MagicPrince666/smart_car_chassis/docs/安装ROS2.md

# 安装ros2

## 安装软件包
```
sudo apt install -y build-essential libbullet-dev python3-colcon-common-extensions python3-flake8 python3-pip python3-pytest-cov python3-rosdep2 python3-setuptools python3-vcstool wget
```
