MagicPrince666/smart_car_chassis/docs/驱动板原理图.jpg

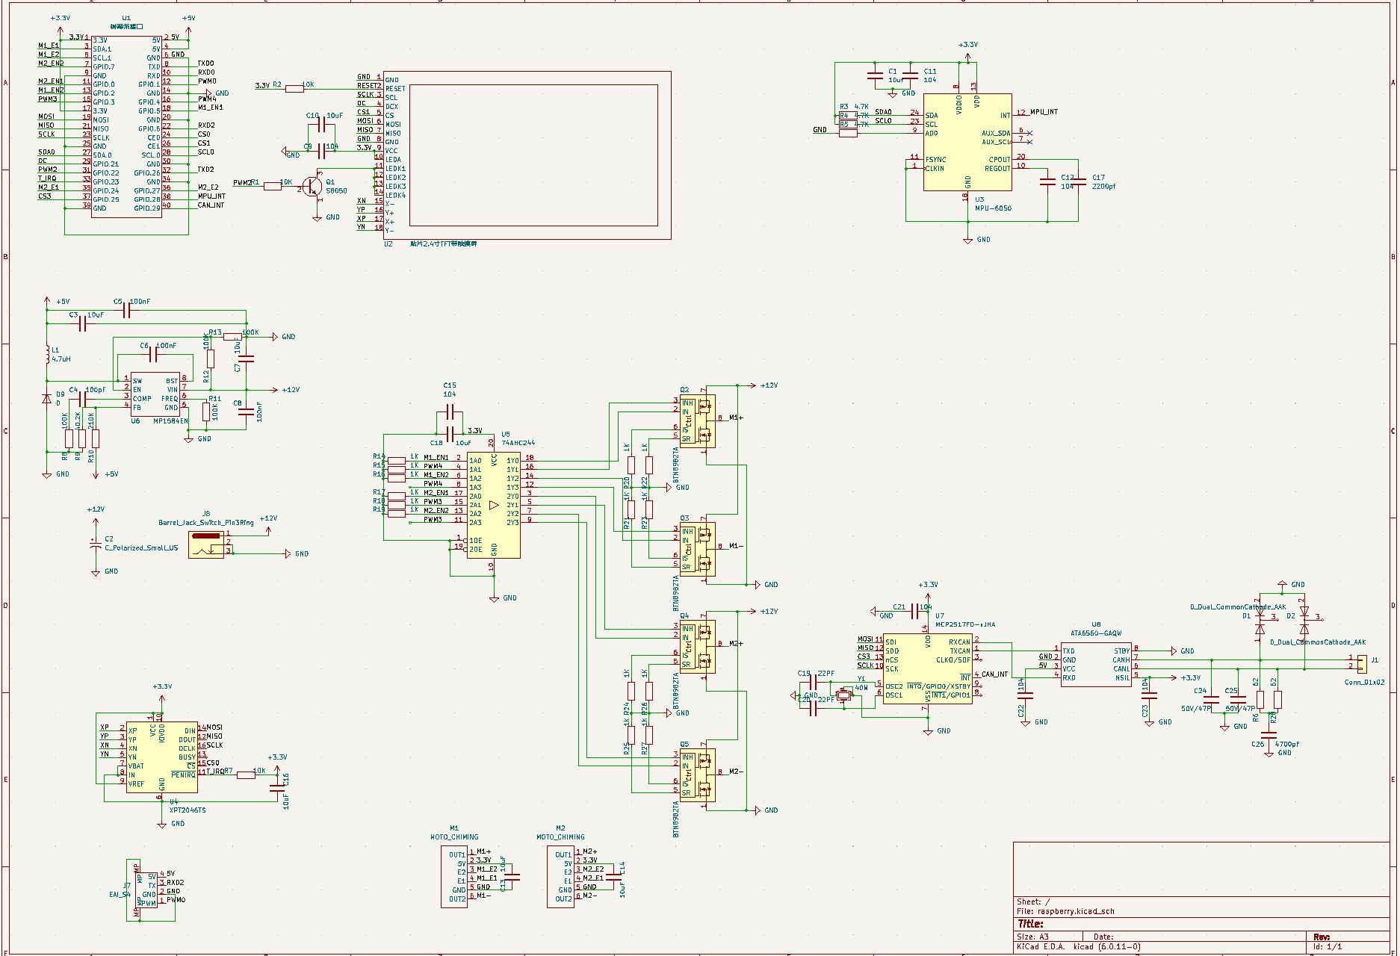
docs/驱动板原理图.jpg
