MagicPrince666/smart_car_chassis/docs/鲁班猫0驱动板原理图.pdf

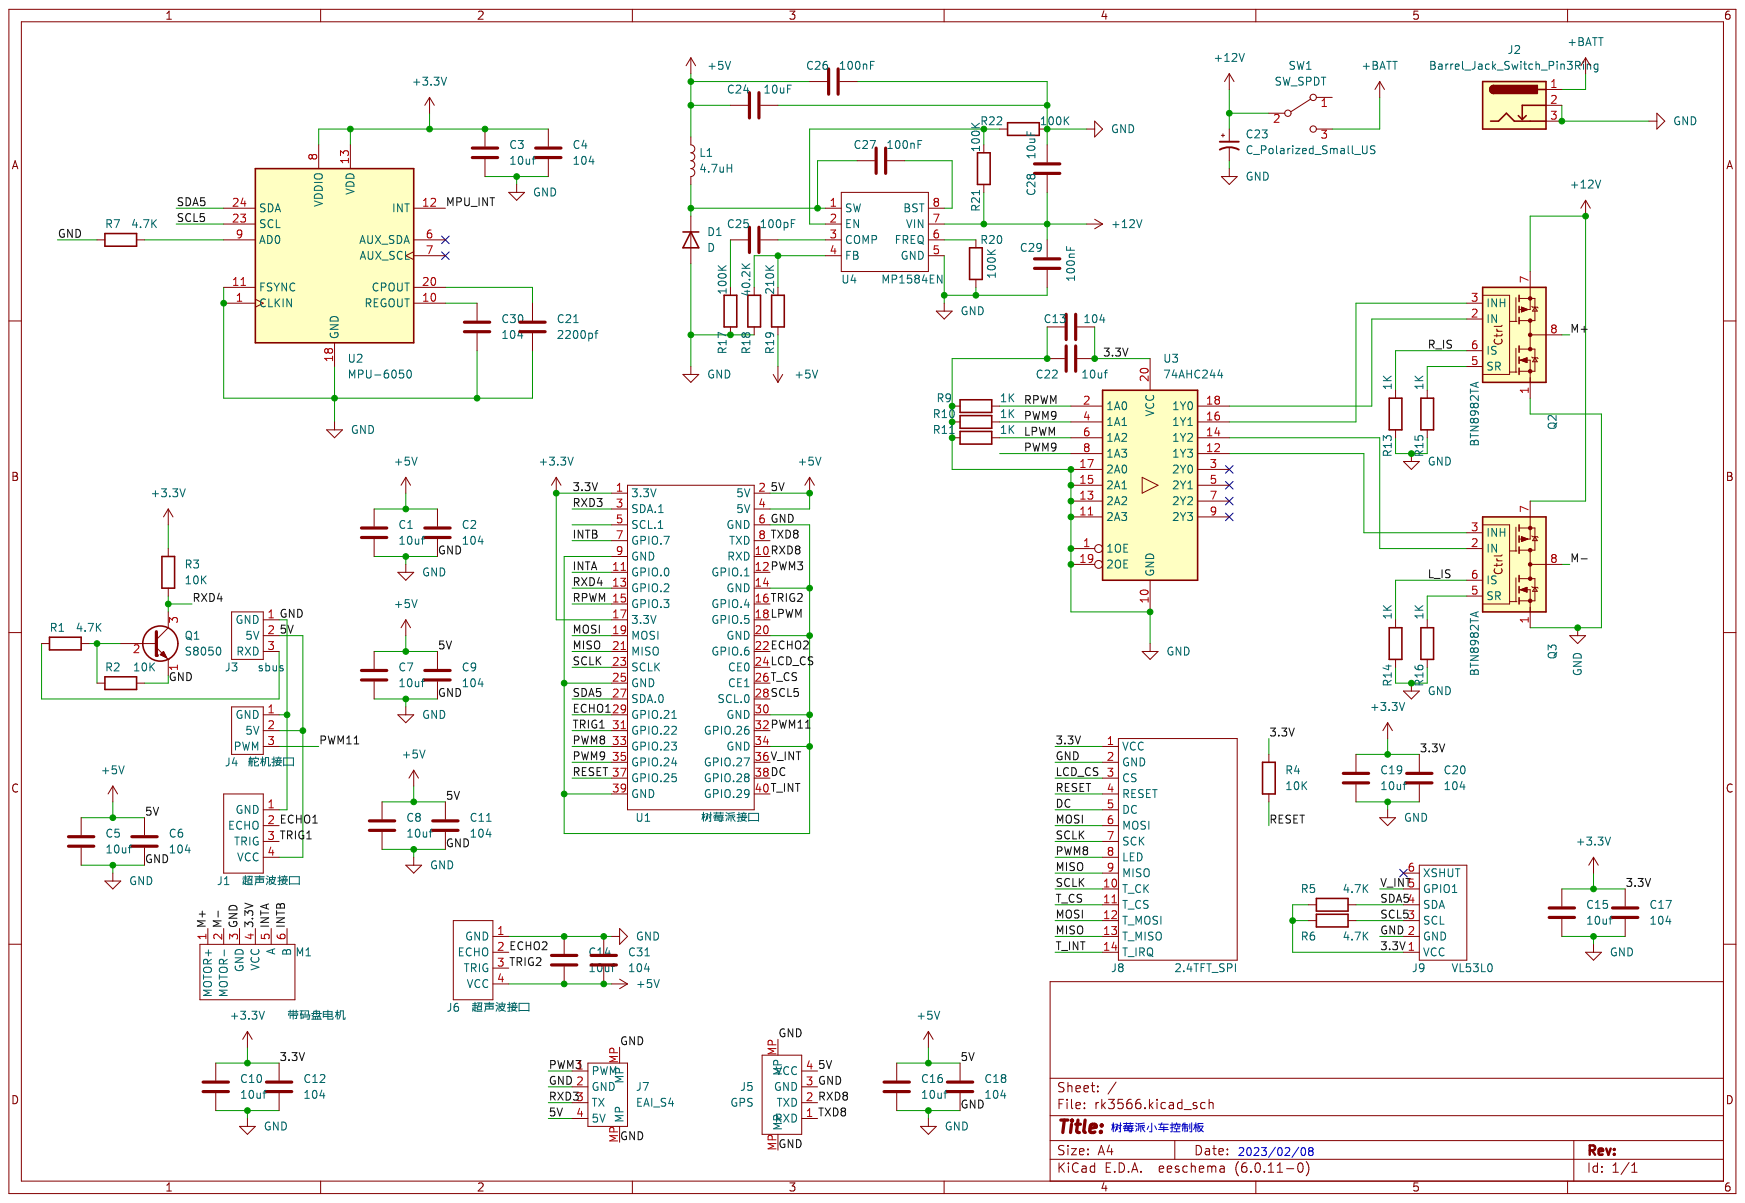
[picture p37: page 1]
