MagicPrince666/smart_car_chassis/docs/kicad/h616/raspberry.kicad_pcb

## KiCad design docs/kicad/h616/raspberry.kicad_pcb (2024-03-04)

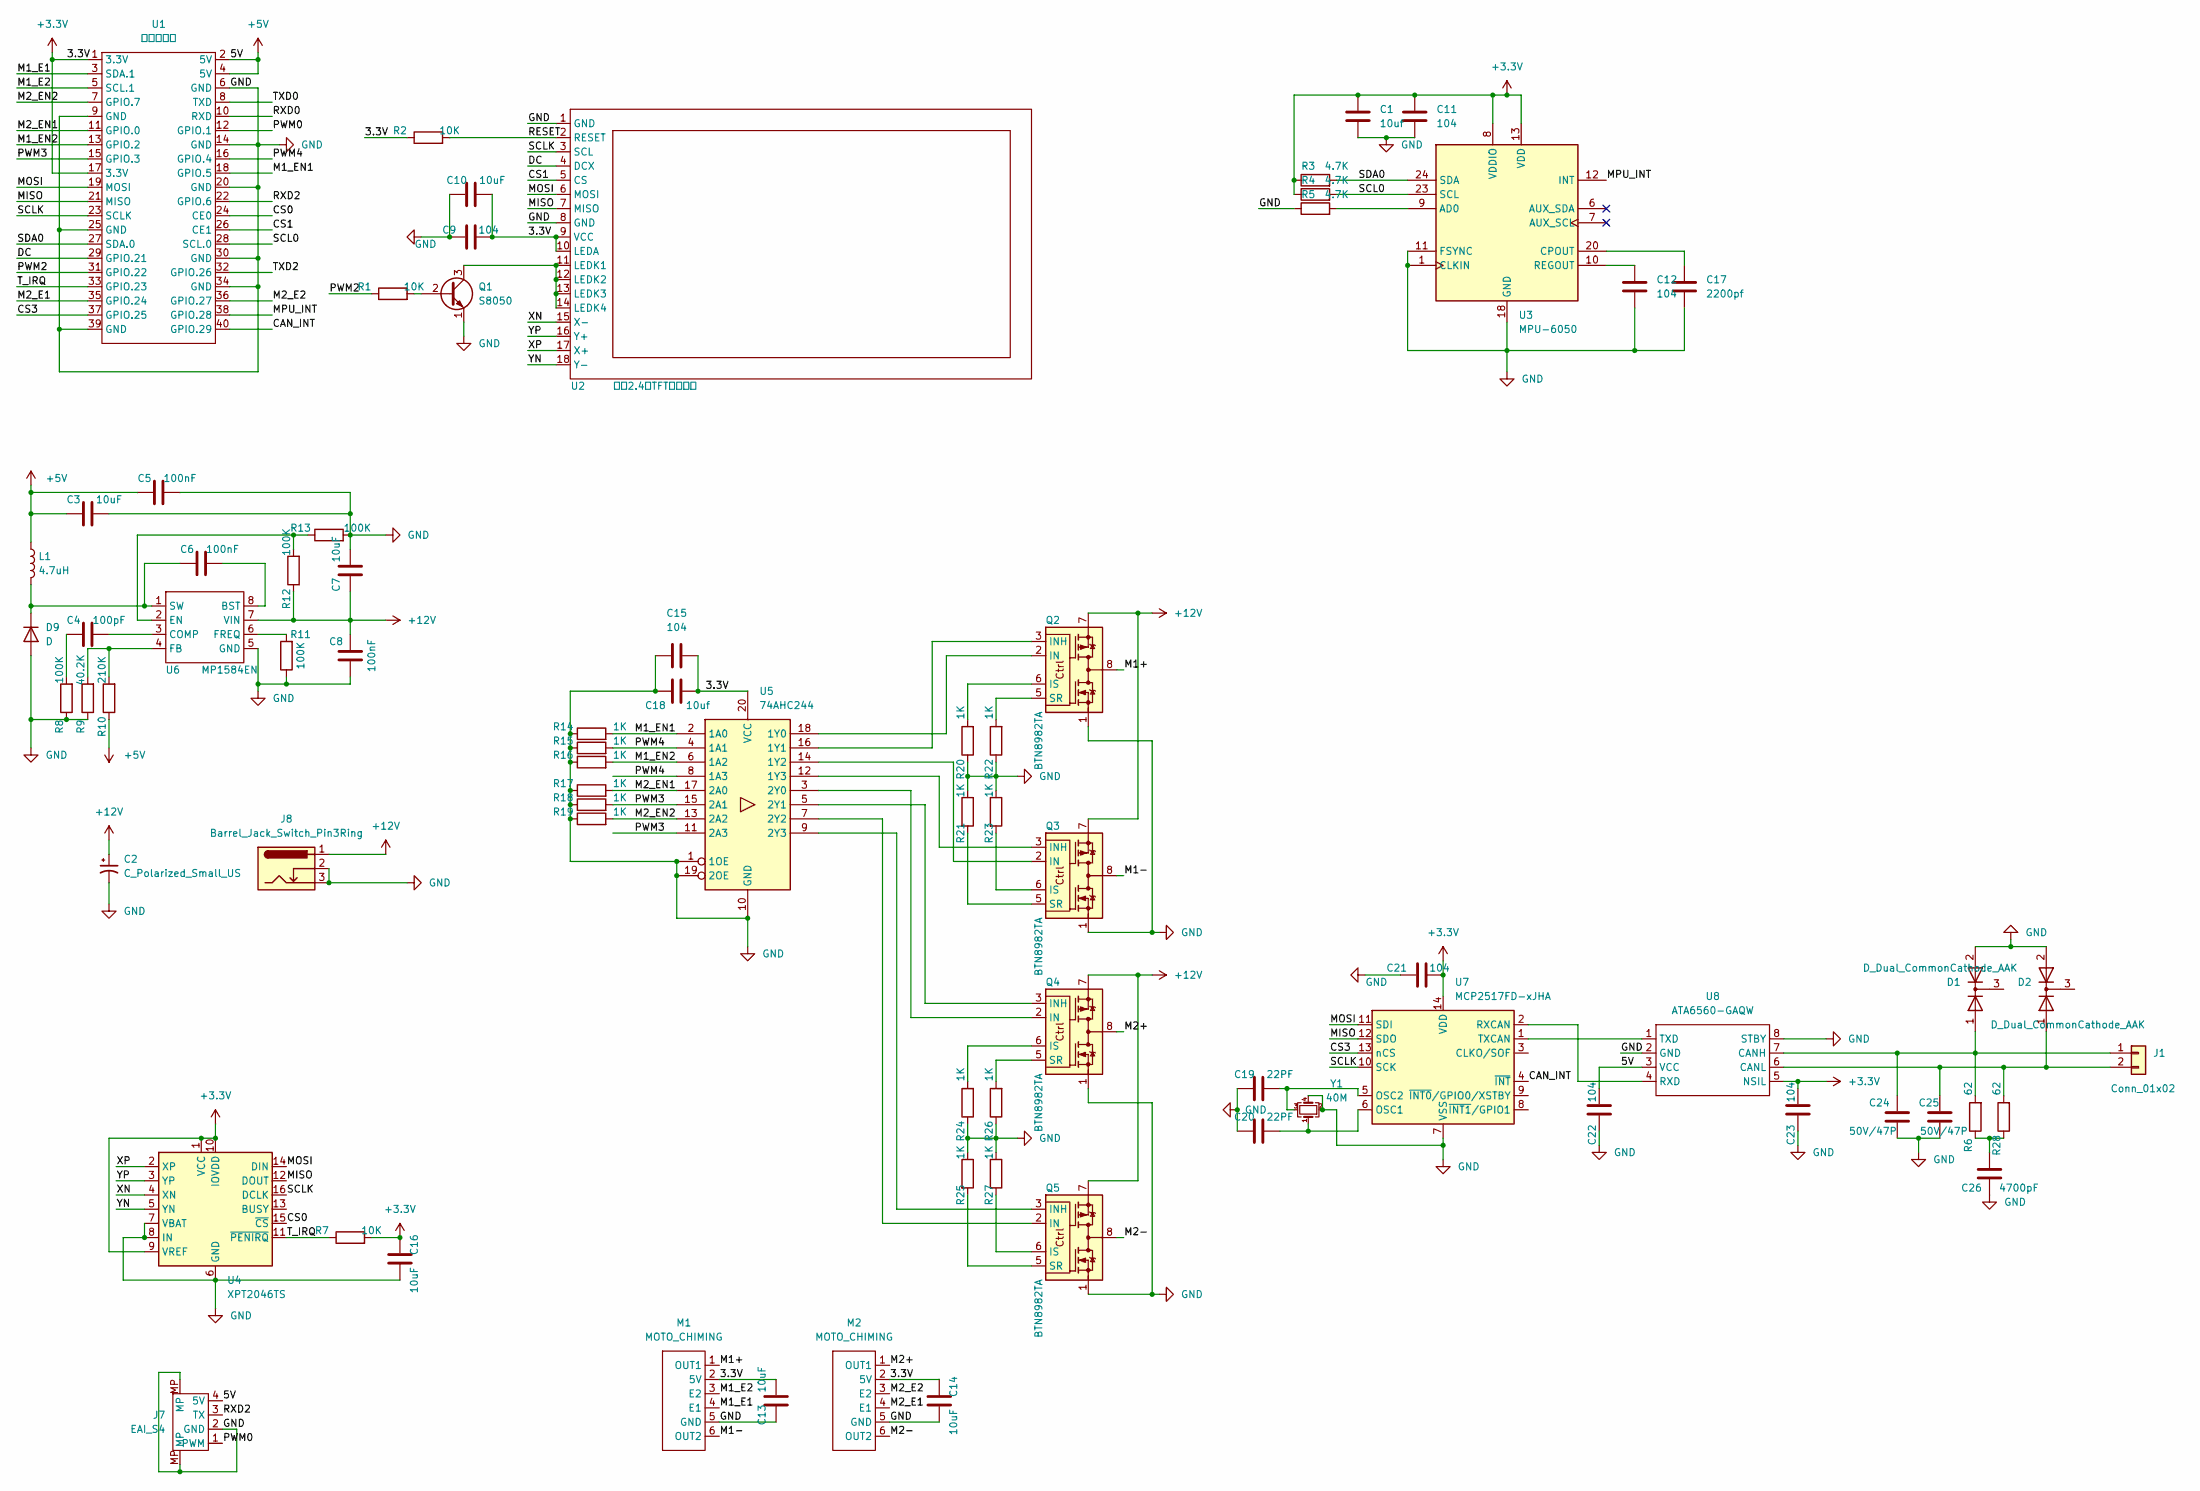
[picture p38: schematic raspberry.kicad_sch]

Parts:
C1, C18: 10uf; C_0805_2012Metric
C2: C_Polarized_Small_US; CP_Radial_D5.0mm_P2.50mm
C3, C7, C10, C13, C14, C16: 10uF; C_0603_1608Metric
C4: 100pF; C_0402_1005Metric
C5, C6, C8: 100nF; C_0402_1005Metric
C9, C11, C12, C15, C21, C22, C23: 104; C_0402_1005Metric
C17: 2200pf; C_0402_1005Metric
C19, C20: 22PF; C_0402_1005Metric
C24, C25: 50V/47P; C_0402_1005Metric
C26: 4700pF; C_0402_1005Metric
D1, D2: D_Dual_CommonCathode_AAK; SOT-23-3
D9: D; D_MELF
J1: Conn_01x02; PinHeader_1x02_P2.54mm_Vertical
J7: EAI_S4
J8: Barrel_Jack_Switch_Pin3Ring; BarrelJack_GCT_DCJ200-10-A_Horizontal
L1: 4.7uH; L_6.3x6.3_H3
M1, M2: MOTO_CHIMING; PinSocket_1x06_P2.00mm_Vertical
Q1: S8050; SOT-23
Q2, Q3, Q4, Q5: BTN8982TA; TO-263-7_TabPin8
R1, R2, R7: 10K; R_0402_1005Metric
R3, R4, R5: 4.7K; R_0402_1005Metric
R6, R28: 62; R_0402_1005Metric
R8, R11, R12, R13: 100K; R_0402_1005Metric
R9: 40.2K; R_0402_1005Metric
R10: 210K; R_0402_1005Metric
R14, R15, R16, R17, R18, R19, R20, R21, R22, R23, R24, R25, R26, R27: 1K; R_0402_1005Metric
U1: 树莓派接口; HEARD2x40
U2: 贴片2.4寸TFT带触摸屏; 2.4TFT_TOUCH
U3: MPU-6050; InvenSense_QFN-24_4x4mm_P0.5mm
U4: XPT2046TS; TSSOP-16_4.4x5mm_P0.65mm
U5: 74AHC244
U6: MP1584EN; HTSOP-8-1EP_3.9x4.9mm_Pitch1.27mm_LargeCopper
U7: MCP2517FD-xJHA; DFN-14-1EP_3x4.5mm_P0.65mm_EP1.65x4.25mm
U8: ATA6560-GAQW; HTSOP-8-1EP_3.9x4.9mm_Pitch1.27mm_ThermalVias
Y1: 40M; Oscillator_SMD_Abracon_ASCO-4Pin_1.6x1.2mm

Connections:
+3.3V: C1.1, C9.2, C10.2, C11.1, C13.2, C14.1, C15.1, C16.1, C18.2, C21.2, C23.2, M1.2 (5V), M2.2 (5V), R2.1, R3.1, R4.1, R7.2, U1.1 (3.3V), U1.17 (3.3V), U2.9 (VCC), U2.10 (LEDA), U3.8 (VDDIO), U3.13 (VDD), U4.1 (VCC), U4.9 (VREF), U4.10 (IOVDD), U5.20 (VCC), U7.14 (VDD), U8.5 (NSIL)
+5V: C3.1, C5.1, C22.2, J7.4 (5V), L1.1, R10.1, U1.2 (5V), U1.4 (5V), U8.3 (VCC)
+12V: C2.1, C7.1, C8.2, J8.1, Q2.7, Q3.7, Q4.7, Q5.7, R12.1, U6.7 (VIN)
/CAN_INT: U1.40 (GPIO.29), U7.4 (~INT)
/CS0: U1.24 (CE0), U4.15 (~CS)
/CS1: U1.26 (CE1), U2.5 (CS)
/CS3: U1.37 (GPIO.25), U7.13 (nCS)
/DC: U1.29 (GPIO.21), U2.4 (DCX)
/M1+: M1.1 (OUT1), Q2.4, Q2.8
/M1-: M1.6 (OUT2), Q3.4, Q3.8
/M1_E1: M1.4 (E1), U1.3 (SDA.1)
/M1_E2: M1.3 (E2), U1.5 (SCL.1)
/M1_EN1: R14.2, U1.18 (GPIO.5), U5.2 (1A0)
/M1_EN2: R16.2, U1.13 (GPIO.2), U5.6 (1A2)
/M2+: M2.1 (OUT1), Q4.4, Q4.8
/M2-: M2.6 (OUT2), Q5.4, Q5.8
/M2_E1: M2.4 (E1), U1.35 (GPIO.24)
/M2_E2: M2.3 (E2), U1.36 (GPIO.27)
/M2_EN1: R17.2, U1.11 (GPIO.0), U5.17 (2A0)
/M2_EN2: R19.2, U1.7 (GPIO.7), U5.13 (2A2)
/MISO: U1.21 (MISO), U2.7 (MISO), U4.12 (DOUT), U7.12 (SDO)
/MOSI: U1.19 (MOSI), U2.6 (MOSI), U4.14 (DIN), U7.11 (SDI)
/MPU_INT: U1.38 (GPIO.28), U3.12 (INT)
/PWM0: J7.1 (PWM), U1.12 (GPIO.1)
/PWM2: R1.1, U1.31 (GPIO.22)
/PWM3: R18.2, U1.15 (GPIO.3), U5.11 (2A3), U5.15 (2A1)
/PWM4: R15.2, U1.16 (GPIO.4), U5.4 (1A1), U5.8 (1A3)
/RESET: R2.2, U2.2 (RESET)
/RXD0: U1.10 (RXD)
/RXD2: J7.3 (TX), U1.22 (GPIO.6)
/SCL0: R4.2, U1.28 (SCL.0), U3.23 (SCL)
/SCLK: U1.23 (SCLK), U2.3 (SCL), U4.16 (DCLK), U7.10 (SCK)
/SDA0: R3.2, U1.27 (SDA.0), U3.24 (SDA)
/TXD0: U1.8 (TXD)
/TXD2: U1.32 (GPIO.26)
/T_IRQ: R7.1, U1.33 (GPIO.23), U4.11 (~PENIRQ)
/XN: U2.15 (X-), U4.4 (XN)
/XP: U2.17 (X+), U4.2 (XP)
/YN: U2.18 (Y-), U4.5 (YN)
/YP: U2.16 (Y+), U4.3 (YP)
GND: C1.2, C2.2, C3.2, C5.2, C7.2, C8.1, C9.1, C10.1, C11.2, C12.2, C13.1, C14.2, C15.2, C16.2, C17.2, C18.1, C19.1, C20.1, C21.1, C22.1, C23.1, C24.1, C25.1, C26.1, D1.2 (A), D2.2 (A), D9.2 (A), J7.2 (GND), J7.MP, J8.2, J8.3, M1.5 (GND), M2.5 (GND), Q1.1 (E), Q2.1, Q3.1, Q4.1, Q5.1, R5.1, R8.1, R9.1, R11.1, R13.2, R14.1, R15.1, R16.1, R17.1, R18.1, R19.1, R20.1, R21.1, R22.1, R23.1, R24.1, R25.1, R26.1, R27.1, U1.6 (GND), U1.9 (GND), U1.14 (GND), U1.20 (GND), U1.25 (GND), U1.30 (GND), U1.34 (GND), U1.39 (GND), U2.1 (GND), U2.8 (GND), U3.1 (CLKIN), U3.11 (FSYNC), U3.18 (GND), U4.6 (GND), U4.7 (VBAT), U4.8 (IN), U5.1 (1OE), U5.10 (GND), U5.19 (2OE), U6.5 (GND), U7.7 (VSS), U7.15 (VSS), U8.2 (GND), U8.8 (STBY), Y1.2, Y1.4
unnamed: C4.1, R8.2
unnamed: C4.2, U6.3 (COMP)
unnamed: C6.1, D9.1 (K), L1.2, U6.1 (SW)
unnamed: C6.2, U6.8 (BST)
unnamed: C12.1, U3.10 (REGOUT)
unnamed: C17.1, U3.20 (CPOUT)
unnamed: C19.2, U7.5 (OSC2), Y1.3
unnamed: C20.2, U7.6 (OSC1), Y1.1
unnamed: C24.2, D1.1 (A), J1.1, R6.2, U8.7 (CANH)
unnamed: C25.2, D2.1 (A), J1.2, R28.2, U8.6 (CANL)
unnamed: C26.2, R6.1, R28.1
unnamed: Q1.2 (B), R1.2
unnamed: Q1.3 (C), U2.11 (LEDK1), U2.12 (LEDK2), U2.13 (LEDK3), U2.14 (LEDK4)
unnamed: Q2.2 (IN), U5.18 (1Y0)
unnamed: Q2.3 (INH), U5.16 (1Y1)
unnamed: Q2.5 (SR), R22.2
unnamed: Q2.6 (IS), R20.2
unnamed: Q3.2 (IN), U5.14 (1Y2)
unnamed: Q3.3 (INH), U5.12 (1Y3)
unnamed: Q3.5 (SR), R21.2
unnamed: Q3.6 (IS), R23.2
unnamed: Q4.2 (IN), U5.3 (2Y0)
unnamed: Q4.3 (INH), U5.5 (2Y1)
unnamed: Q4.5 (SR), R26.2
unnamed: Q4.6 (IS), R24.2
unnamed: Q5.2 (IN), U5.7 (2Y2)
unnamed: Q5.3 (INH), U5.9 (2Y3)
unnamed: Q5.5 (SR), R25.2
unnamed: Q5.6 (IS), R27.2
unnamed: R5.2, U3.9 (AD0)
unnamed: R9.2, R10.2, U6.4 (FB)
unnamed: R11.2, U6.6 (FREQ)
unnamed: R12.2, R13.1, U6.2 (EN)
unnamed: U7.1 (TXCAN), U8.1 (TXD)
unnamed: U7.2 (RXCAN), U8.4 (RXD)

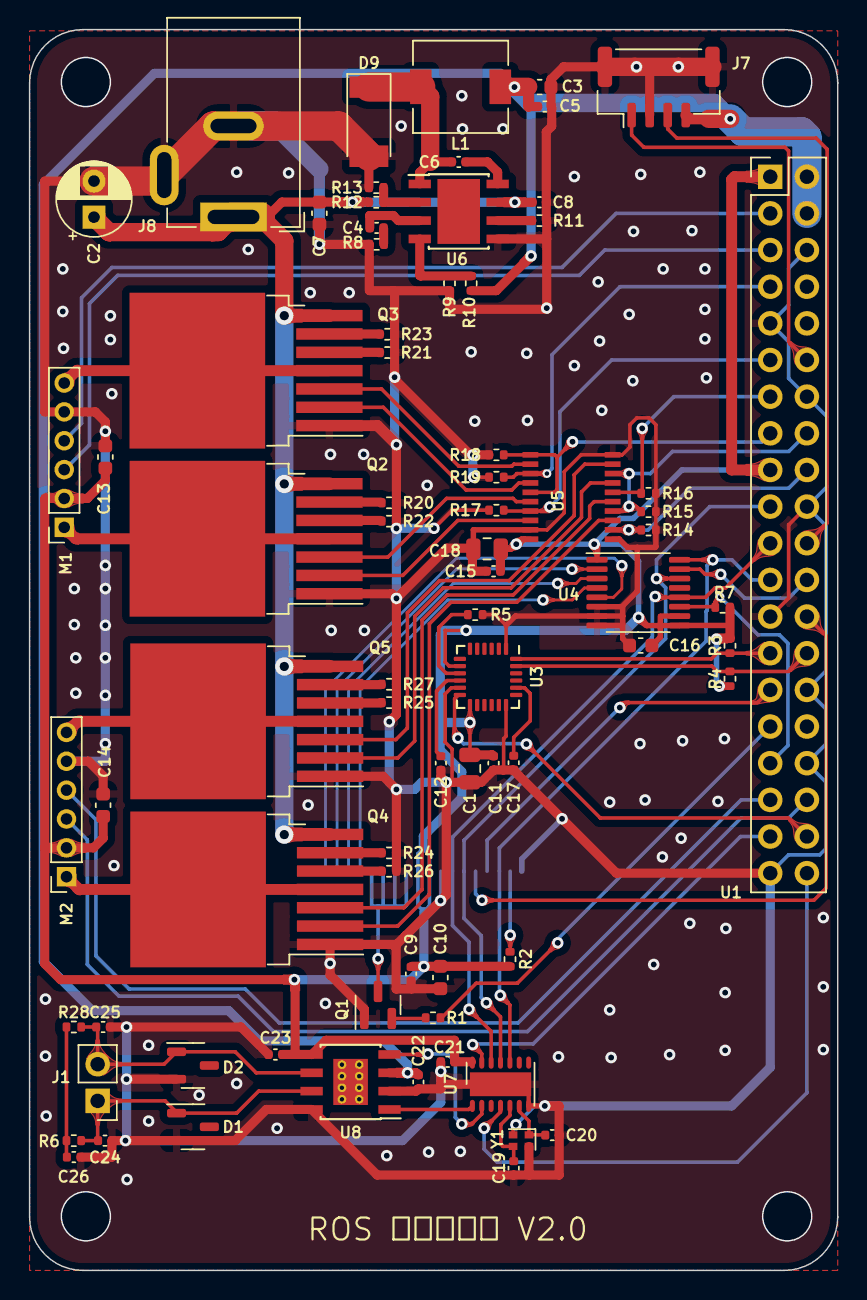
[picture p39: board raspberry.kicad_pcb from above]

Board: 2 copper layers, 56.0 x 86.0 mm, 77 parts (1 on the bottom side), 73 nets.
