MagicPrince666/smart_car_chassis/docs/kicad/rk3566/rk3566.kicad_pcb

## KiCad design docs/kicad/rk3566/rk3566.kicad_pcb (2024-06-17)

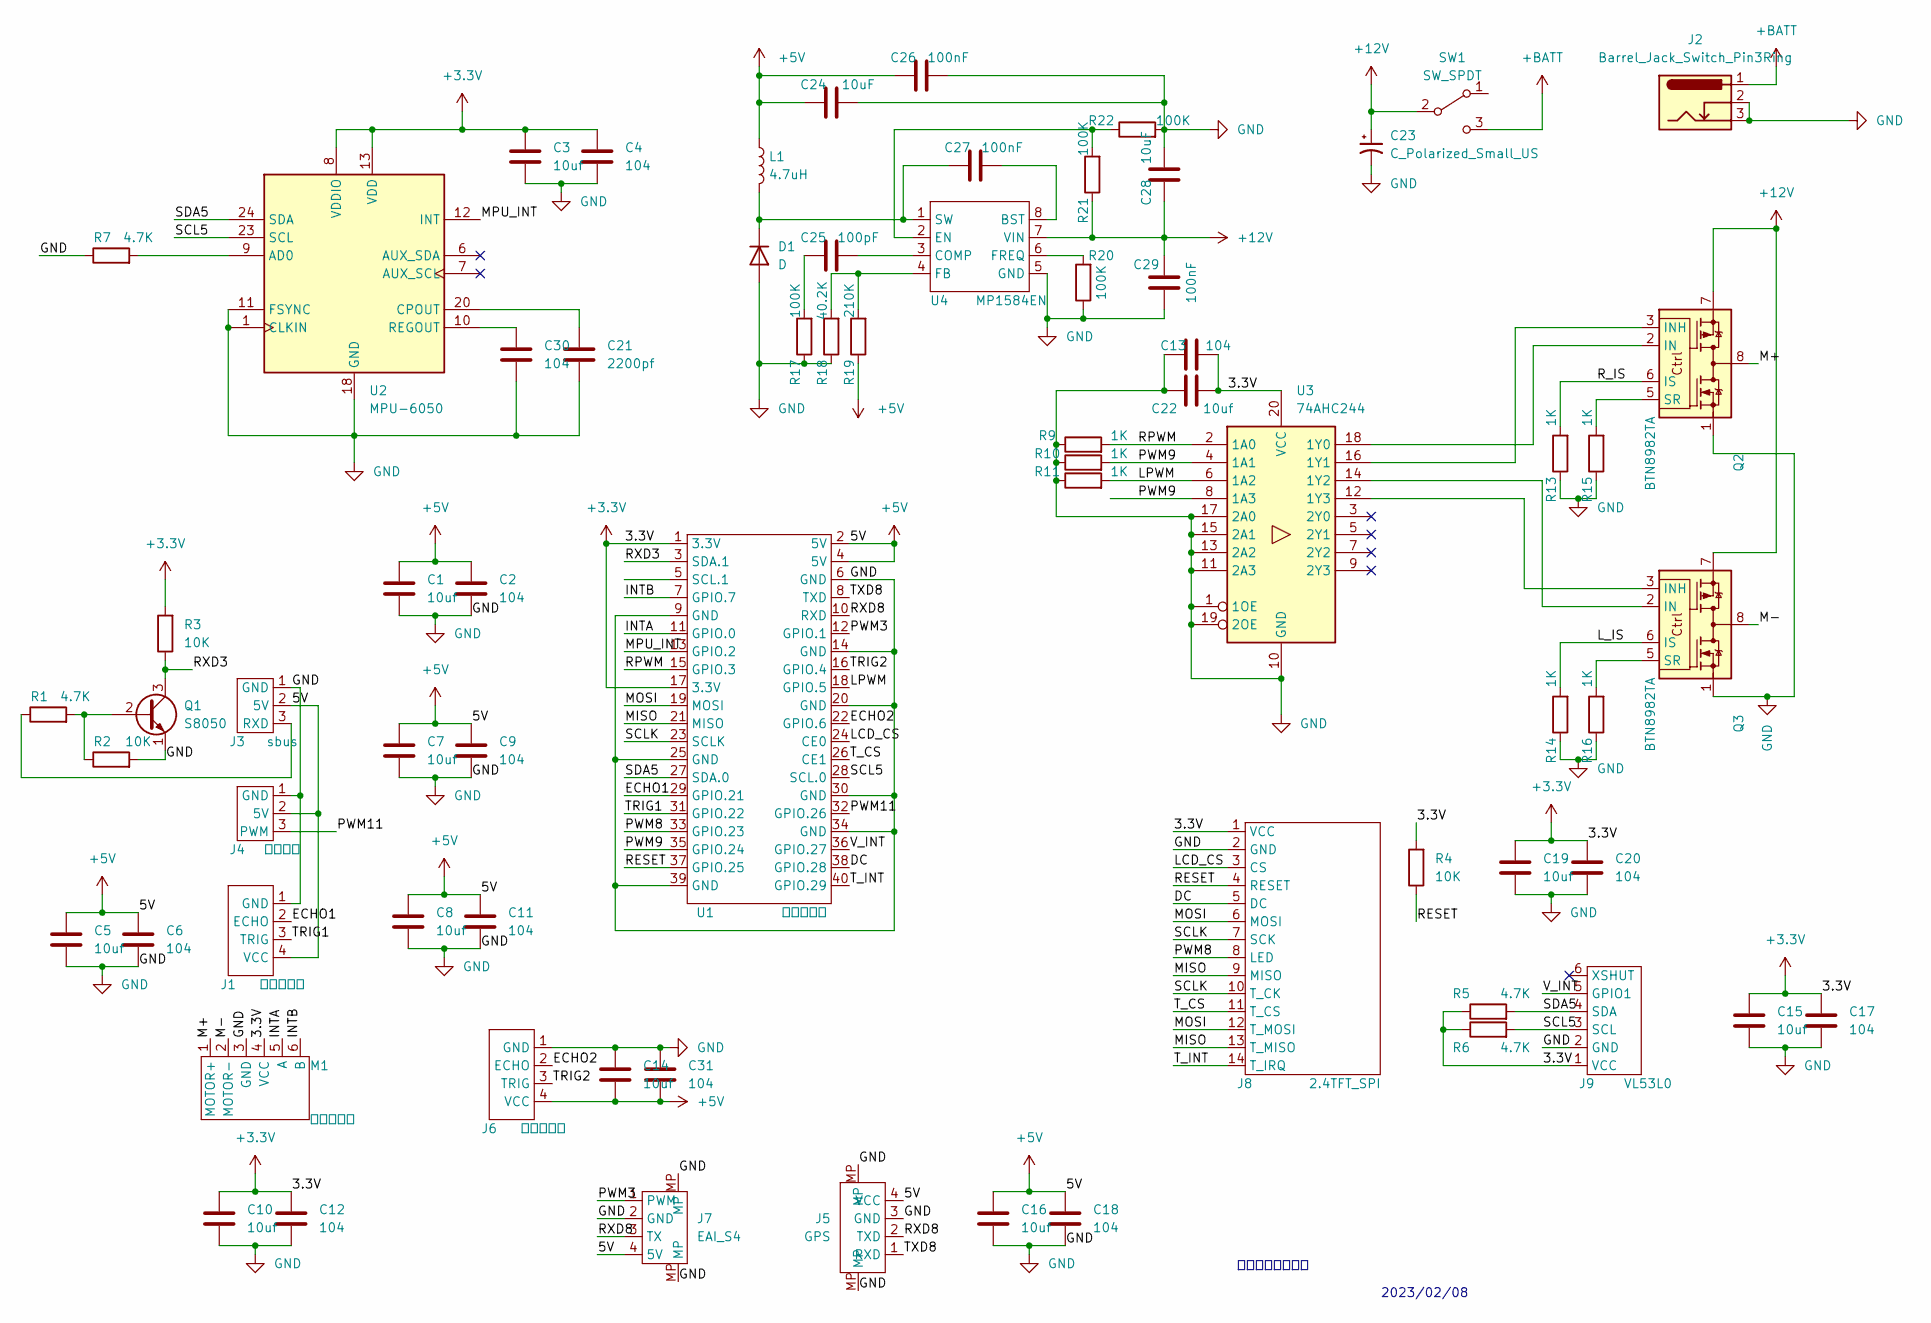
[picture p40: schematic rk3566.kicad_sch]

Parts:
C1, C22: 10uf; C_0603_1608Metric
C2, C4, C6, C9, C11, C12, C13, C17, C18, C20, C30, C31: 104; C_0402_1005Metric
C3, C5, C7, C8, C10, C14, C15, C16, C19: 10uf; C_0805_2012Metric
C21: 2200pf; C_0402_1005Metric
C23: C_Polarized_Small_US; CP_Radial_D5.0mm_P2.50mm
C24, C28: 10uF; C_0603_1608Metric
C25: 100pF; C_0402_1005Metric
C26, C27, C29: 100nF; C_0402_1005Metric
D1: D; D_MELF
J1, J6: 超声波接口; HDR1x04_2.54mm
J2: Barrel_Jack_Switch_Pin3Ring; BarrelJack_GCT_DCJ200-10-A_Horizontal
J3: sbus; SBUS
J4: 舵机接口; SBUS
J5: GPS; EAI_S4
J7: EAI_S4
J8: 2.4TFT_SPI; 2.4_TFT_SPI
J9: VL53L0; HDR1x06_2.54mm
L1: 4.7uH; L_6.3x6.3_H3
M1: 带码盘电机; HDR1x06_2.54mm
Q1: S8050; s8050
Q2, Q3: BTN8982TA; TO-263-7_TabPin8
R1, R5, R6, R7: 4.7K; R_0402_1005Metric
R2, R3, R4: 10K; R_0402_1005Metric
R9, R10, R11, R13, R14, R15, R16: 1K; R_0402_1005Metric
R17, R20, R21, R22: 100K; R_0402_1005Metric
R18: 40.2K; R_0402_1005Metric
R19: 210K; R_0402_1005Metric
SW1: SW_SPDT; TerminalBlock_RND_205-00288_1x03_P5.08mm_Horizontal
U1: 树莓派接口; HEARD2x40
U2: MPU-6050; InvenSense_QFN-24_4x4mm_P0.5mm
U3: 74AHC244
U4: MP1584EN; HTSOP-8-1EP_3.9x4.9mm_Pitch1.27mm_LargeCopper

Connections:
+3.3V: C3.1, C4.1, C10.1, C12.1, C13.2, C15.1, C17.1, C19.1, C20.1, C22.2, J8.1 (VCC), J9.1 (VCC), M1.4 (VCC), R3.2, R4.2, R5.1, R6.1, U1.1 (3.3V), U1.17 (3.3V), U2.8 (VDDIO), U2.13 (VDD), U3.20 (VCC); also elsewhere on the board
+5V: C1.1, C2.1, C5.1, C6.1, C7.1, C8.1, C9.1, C11.1, C14.2, C16.1, C18.1, C24.1, C26.1, C31.2, J1.4 (VCC), J3.2 (5V), J4.2 (5V), J5.4 (VCC), J6.4 (VCC), J7.4 (5V), L1.1, R19.1, U1.2 (5V), U1.4 (5V)
+12V: C23.1, C28.1, C29.2, Q2.7, Q3.7, R21.1, SW1.2 (B), U4.7 (VIN)
+BATT: J2.1, SW1.3 (C)
/DC: J8.5 (DC), U1.38 (GPIO.28)
/ECHO1: J1.2 (ECHO), U1.29 (GPIO.21)
/ECHO2: J6.2 (ECHO), U1.22 (GPIO.6)
/INTA: M1.5 (A), U1.11 (GPIO.0)
/INTB: M1.6 (B), U1.7 (GPIO.7)
/LCD_CS: J8.3 (CS), U1.24 (CE0)
/LPWM: R11.2, U1.18 (GPIO.5), U3.6 (1A2)
/L_IS: Q3.6 (IS), R14.2
/M+: M1.1 (MOTOR+), Q2.4, Q2.8
/M-: M1.2 (MOTOR-), Q3.4, Q3.8
/MISO: J8.9 (MISO), J8.13 (T_MISO), U1.21 (MISO)
/MOSI: J8.6 (MOSI), J8.12 (T_MOSI), U1.19 (MOSI)
/MPU_INT: U1.13 (GPIO.2), U2.12 (INT)
/PWM3: J7.1 (PWM), U1.12 (GPIO.1)
/PWM8: J8.8 (LED), U1.33 (GPIO.23)
/PWM9: R10.2, U1.35 (GPIO.24), U3.4 (1A1), U3.8 (1A3)
/PWM11: J4.3 (PWM), U1.32 (GPIO.26)
/RESET: J8.4 (RESET), R4.1, U1.37 (GPIO.25)
/RPWM: R9.2, U1.15 (GPIO.3), U3.2 (1A0)
/RXD3: Q1.3 (C), R3.1, U1.3 (SDA.1)
/RXD8: J5.2 (TXD), J7.3 (TX), U1.10 (RXD)
/R_IS: Q2.6 (IS), R13.2
/SCL5: J9.3 (SCL), R6.2, U1.28 (SCL.0), U2.23 (SCL)
/SCLK: J8.7 (SCK), J8.10 (T_CK), U1.23 (SCLK)
/SDA5: J9.4 (SDA), R5.2, U1.27 (SDA.0), U2.24 (SDA)
/TRIG1: J1.3 (TRIG), U1.31 (GPIO.22)
/TRIG2: J6.3 (TRIG), U1.16 (GPIO.4)
/TXD8: J5.1 (RXD), U1.8 (TXD)
/T_CS: J8.11 (T_CS), U1.26 (CE1)
/T_INT: J8.14 (T_IRQ), U1.40 (GPIO.29)
/V_INT: J9.5 (GPIO1), U1.36 (GPIO.27)
GND: C1.2, C2.2, C3.2, C4.2, C5.2, C6.2, C7.2, C8.2, C9.2, C10.2, C11.2, C12.2, C13.1, C14.1, C15.2, C16.2, C17.2, C18.2, C19.2, C20.2, C21.2, C22.1, C23.2, C24.2, C26.2, C28.2, C29.1, C30.2, C31.1, D1.2 (A), J1.1 (GND), J2.2, J2.3, J3.1 (GND), J4.1 (GND), J5.3 (GND), J5.MP, J6.1 (GND), J7.2 (GND), J7.MP, J8.2 (GND), J9.2 (GND), M1.3 (GND), Q1.1 (E), Q2.1, Q3.1, R2.2, R7.1, R9.1, R10.1, R11.1, R13.1, R14.1, R15.1, R16.1, R17.1, R18.1, R20.1, R22.2, U1.6 (GND), U1.9 (GND), U1.14 (GND), U1.20 (GND), U1.25 (GND), U1.30 (GND), U1.34 (GND), U1.39 (GND), U2.1 (CLKIN), U2.11 (FSYNC), U2.18 (GND), U3.1 (1OE), U3.10 (GND), U3.11 (2A3), U3.13 (2A2), U3.15 (2A1), U3.17 (2A0), U3.19 (2OE), U4.5 (GND); also elsewhere on the board
unnamed: C21.1, U2.20 (CPOUT)
unnamed: C25.1, R17.2
unnamed: C25.2, U4.3 (COMP)
unnamed: C27.1, D1.1 (K), L1.2, U4.1 (SW)
unnamed: C27.2, U4.8 (BST)
unnamed: C30.1, U2.10 (REGOUT)
unnamed: J3.3 (RXD), R1.1
unnamed: Q1.2 (B), R1.2, R2.1
unnamed: Q2.2 (IN), U3.18 (1Y0)
unnamed: Q2.3 (INH), U3.16 (1Y1)
unnamed: Q2.5 (SR), R15.2
unnamed: Q3.2 (IN), U3.14 (1Y2)
unnamed: Q3.3 (INH), U3.12 (1Y3)
unnamed: Q3.5 (SR), R16.2
unnamed: R7.2, U2.9 (AD0)
unnamed: R18.2, R19.2, U4.4 (FB)
unnamed: R20.2, U4.6 (FREQ)
unnamed: R21.2, R22.1, U4.2 (EN)

Notes on the sheet:
2023/02/08
树莓派小车控制板

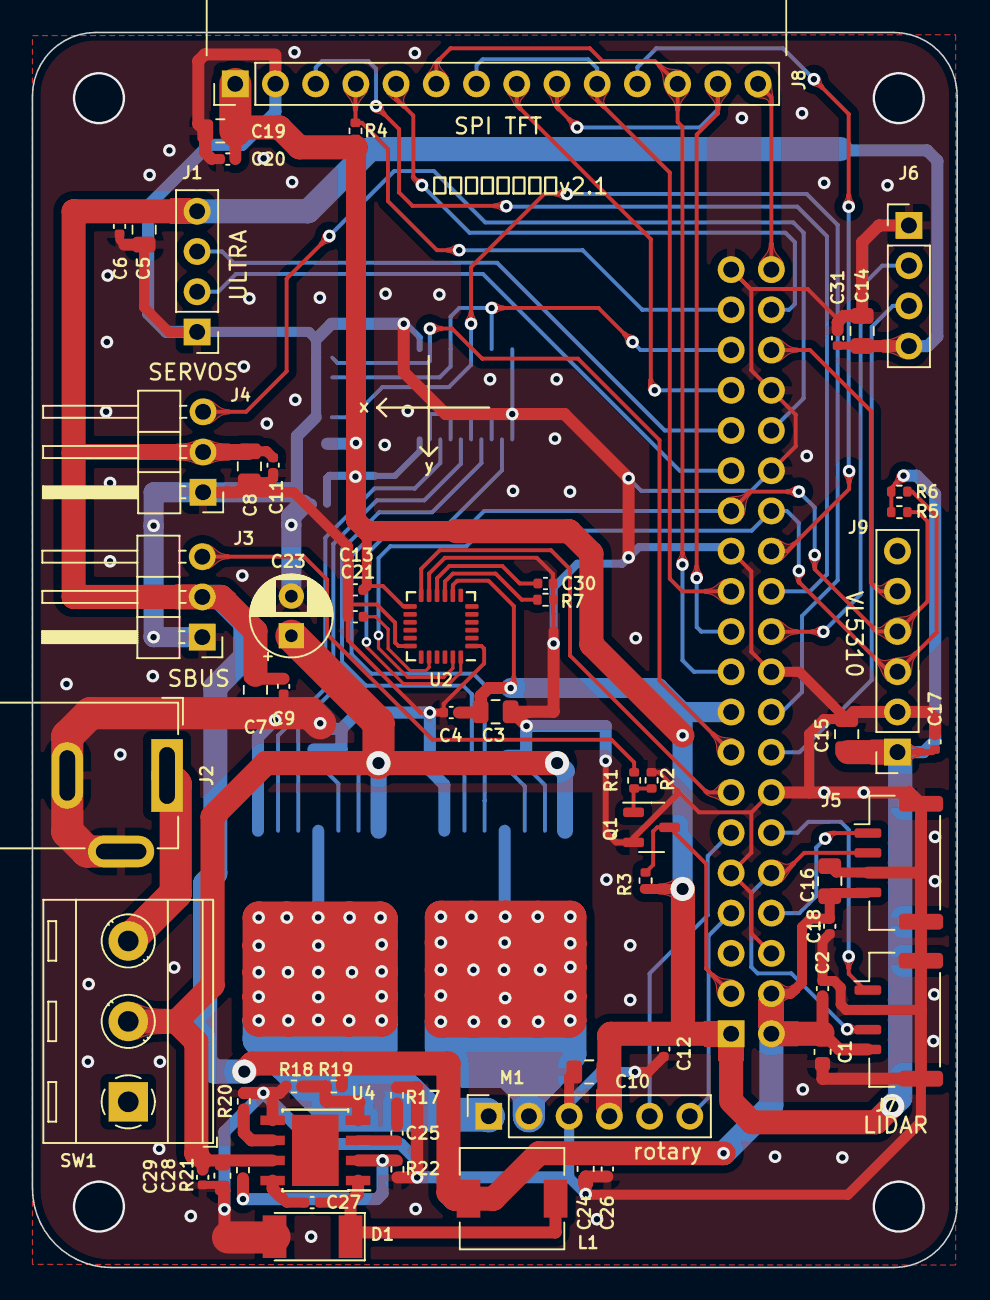
[picture p41: board rk3566.kicad_pcb from above]

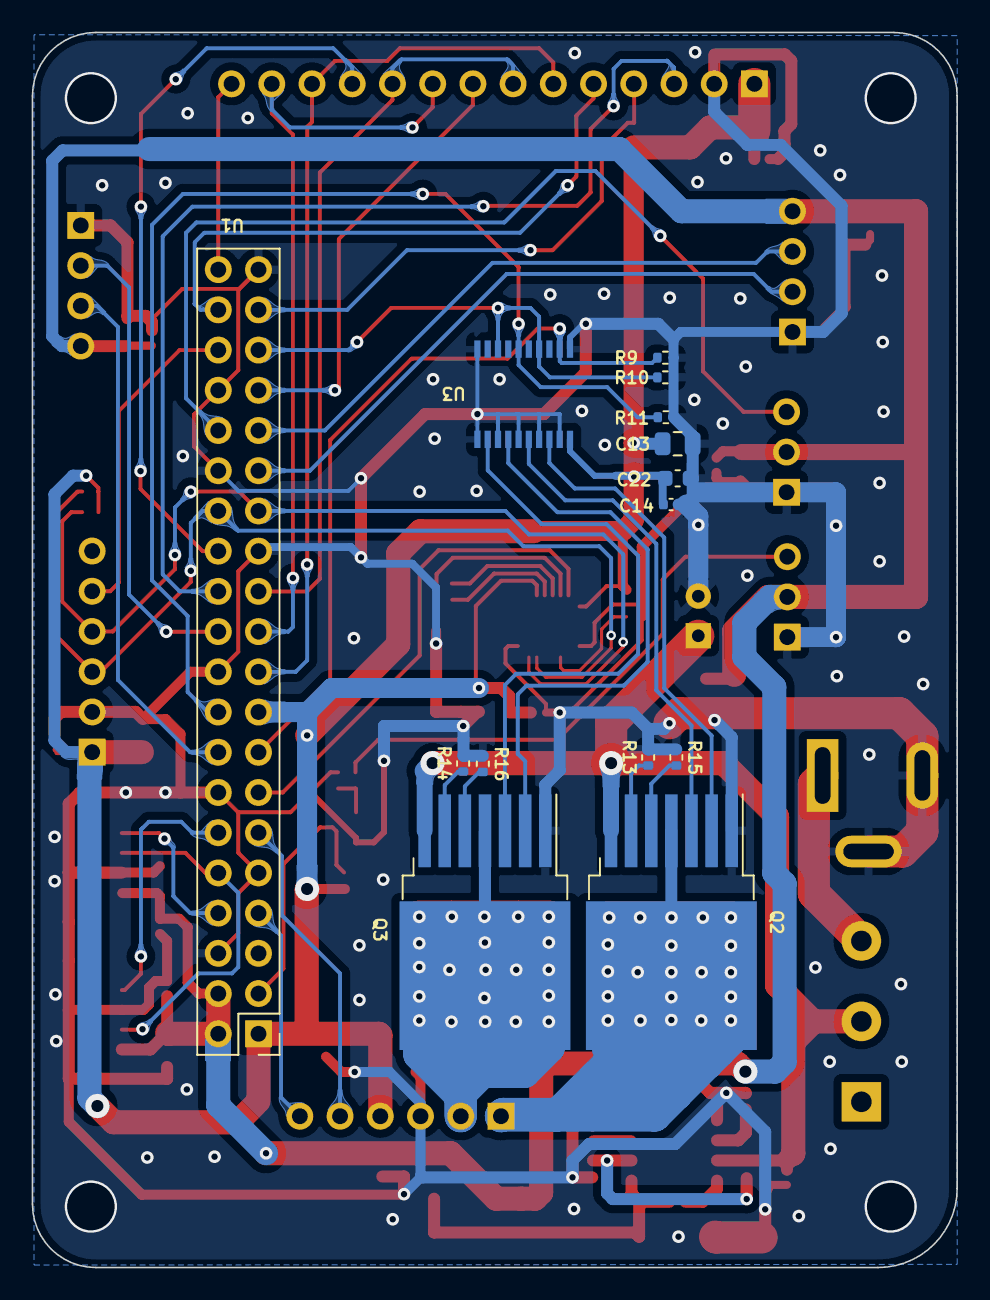
[picture p42: board rk3566.kicad_pcb from below]

Board: 2 copper layers, 58.4 x 78.0 mm, 73 parts (14 on the bottom side), 54 nets.

Other parts of the board:
C13#2: 10uf; C_0805_2012Metric
C14#2: 104; C_0402_1005Metric

Their connections:
+3.3V: C13#2.1, C14#2.1; also elsewhere on the board
GND: C13#2.2, C14#2.2; also elsewhere on the board
