MagicPrince666/smart_car_chassis/docs/rk3566-lubancat-0.dts

// SPDX-License-Identifier: (GPL-2.0+ OR MIT)
/*
 * Copyright (c) 2020 Rockchip Electronics Co., Ltd.
 *
 */

 /dts-v1/;

#include <dt-bindings/gpio/gpio.h>
#include <dt-bindings/pwm/pwm.h>
#include <dt-bindings/pinctrl/rockchip.h>
#include <dt-bindings/input/rk-input.h>
#include <dt-bindings/display/drm_mipi_dsi.h>
#include <dt-bindings/display/rockchip_vop.h>
#include <dt-bindings/sensor-dev.h>
#include <dt-bindings/phy/jlsemi-dt-phy.h>
#include "rk3566.dtsi"

//MIPI摄像头配置
#include "rk3568-lubancat-csi2.dtsi"

/*  屏幕设置，通用镜像使用设备树插件,默认开启hdmi
	专用镜像如果要开启MIPI屏幕支持，按屏幕型号开启2-4
	以下4个配置互斥，不可同时开启
*/
#include "rk3566-lubancat-hdmi.dtsi" //HDMI输出
// #include "rk3566-lubancat-dsi0-ebf410125_720p.dtsi" //野火5.5寸 720P
// #include "rk3566-lubancat-dsi0-ebf410125_1080p.dtsi" //野火5.5寸 1080P
// #include "rk3566-lubancat-dsi0-rpi.dtsi" //树莓派 5寸 800x480

/ {
	model = "EmbedFire LubanCat-ZeroW";
	compatible = "embedfire,lubancat-zerow", "rockchip,rk3566";

	chosen: chosen {
		bootargs = "earlycon=uart8250,mmio32,0xfe660000 console=ttyFIQ0 root=PARTUUID=614e0000-0000 rw rootwait";
	};

	fiq-debugger {
		compatible = "rockchip,fiq-debugger";
		rockchip,serial-id = <2>;
		rockchip,wake-irq = <0>;
		/* If enable uart uses irq instead of fiq */
		rockchip,irq-mode-enable = <1>;
		rockchip,baudrate = <1500000>;  /* Only 115200 and 1500000 */
		interrupts = <GIC_SPI 252 IRQ_TYPE_LEVEL_LOW>;
		pinctrl-names = "default";
		pinctrl-0 = <&uart2m0_xfer>;
		status = "okay";
	};

	debug: debug@fd904000 {
		compatible = "rockchip,debug";
		reg = <0x0 0xfd904000 0x0 0x1000>,
			<0x0 0xfd905000 0x0 0x1000>,
			<0x0 0xfd906000 0x0 0x1000>,
			<0x0 0xfd907000 0x0 0x1000>;
	};

	cspmu: cspmu@fd90c000 {
		compatible = "rockchip,cspmu";
		reg = <0x0 0xfd90c000 0x0 0x1000>,
			<0x0 0xfd90d000 0x0 0x1000>,
			<0x0 0xfd90e000 0x0 0x1000>,
			<0x0 0xfd90f000 0x0 0x1000>;
	};

	reserved-memory {
		#address-cells = <2>;
		#size-cells = <2>;
		ranges;
		ramoops: ramoops@110000 {
			compatible = "ramoops";
			reg = <0x0 0x110000 0x0 0xf0000>;
			record-size = <0x20000>;
			console-size = <0x80000>;
			ftrace-size = <0x00000>;
			pmsg-size = <0x50000>;
		};
	};

	dc_5v: dc-5v {
		compatible = "regulator-fixed";
		regulator-name = "dc_5v";
		regulator-always-on;
		regulator-boot-on;
		regulator-min-microvolt = <5000000>;
		regulator-max-microvolt = <5000000>;
	};

	vcc5v0_sys: vcc5v0-sys {
		compatible = "regulator-fixed";
		regulator-name = "vcc5v0_sys";
		regulator-always-on;
		regulator-boot-on;
		regulator-min-microvolt = <5000000>;
		regulator-max-microvolt = <5000000>;
		vin-supply = <&dc_5v>;
	};

	vcc3v3_sys: vcc3v3-sys {
		compatible = "regulator-fixed";
		regulator-name = "vcc3v3_sys";
		regulator-always-on;
		regulator-boot-on;
		regulator-min-microvolt = <3300000>;
		regulator-max-microvolt = <3300000>;
		vin-supply = <&vcc5v0_sys>;
	};

	pcie_3v3: pcie2-3v3-regulator {
		compatible = "regulator-fixed";
		regulator-name = "pcie_3v3";
		regulator-min-microvolt = <3300000>;
		regulator-max-microvolt = <3300000>;
		enable-active-high;
		gpio = <&gpio3 RK_PC3 GPIO_ACTIVE_HIGH>;
		startup-delay-us = <5000>;
		vin-supply = <&vcc5v0_sys>;
	};

	mipi_dsi0_power: mipi-dsi0-power-regulator {
		compatible = "regulator-fixed";
		enable-active-high;
		gpio = <&gpio0 RK_PC0 GPIO_ACTIVE_HIGH>;
		pinctrl-names = "default";
		pinctrl-0 = <&mipi_dsi0_pwr_en>;
		regulator-name = "mipi_dsi0_power";
		regulator-always-on;
	};

	vdd_cam_5v: vdd-cam-5v-regulator {
		compatible = "regulator-fixed";
		regulator-name = "vdd_cam_5v";
		regulator-min-microvolt = <3300000>;
		regulator-max-microvolt = <3300000>;
		gpio = <&gpio0 RK_PC6 GPIO_ACTIVE_HIGH>;
		pinctrl-names = "default";
		pinctrl-0 = <&cam_pwr_en>;
		enable-active-high;
		regulator-always-on;
	};

	cam_dovdd: cam-dovdd {
		compatible = "regulator-fixed";
		regulator-name = "cam_dovdd";
		regulator-always-on;
		regulator-boot-on;
		regulator-min-microvolt = <1800000>;
		regulator-max-microvolt = <1800000>;
		vin-supply = <&vdd_cam_5v>;
	};

	cam_avdd: cam-avdd {
		compatible = "regulator-fixed";
		regulator-name = "cam_avdd";
		regulator-always-on;
		regulator-boot-on;
		regulator-min-microvolt = <2800000>;
		regulator-max-microvolt = <2800000>;
		vin-supply = <&vdd_cam_5v>;
	};

	cam_dvdd: cam-dvdd {
		compatible = "regulator-fixed";
		regulator-name = "cam_dvdd";
		regulator-always-on;
		regulator-boot-on;
		regulator-min-microvolt = <1200000>;
		regulator-max-microvolt = <1200000>;
		vin-supply = <&vdd_cam_5v>;
	};

	leds: leds {
		status = "okay";
		compatible = "gpio-leds";

		sys_status_led: sys-status-led {
			label = "sys_status_led";
			linux,default-trigger = "heartbeat";
			default-state = "on";
			gpios = <&gpio0 RK_PC5 GPIO_ACTIVE_LOW>;
			pinctrl-names = "default";
			pinctrl-0 = <&sys_status_led_pin>;
		};

		moto-enb {
			label = "moto-enb";
			pinctrl-names = "default";
			pinctrl-0 = <&lpwm_pin>;
			gpios = <&gpio2 RK_PC4 GPIO_ACTIVE_HIGH>; // GPIO2_C4
			default-state = "on";
		};

		moto-ena {
			label = "moto-ena";
			pinctrl-names = "default";
			pinctrl-0 = <&rpwm_pin>;
			gpios = <&gpio1 RK_PA5 GPIO_ACTIVE_HIGH>; // GPIO1_A5
			default-state = "on";
		};
	};

	backlight: backlight@0 {
		status = "okay";
		compatible = "pwm-backlight";
		label = "backlight0";
		pwms = <&pwm0 0 50000 0>;
		brightness-levels = <
			95  95  95  95  95  95  95  95
			95  95  95  95  95  95  95  95
			95  95  95  95  95  95  95  95
			95  95  95  95  95  95  95  95
			95  95  95  95  95  95  95  95
			95  95  95  95  95  95  95  95
			95  95  95  95  95  95  95  95
			95  95  95  95  95  95  95  95
			95  95  95  95  95  95  95  95
			95  95  95  95  95  95  95  95
			95  95  95  95  95  95  95  95
			88  89  90  91  92  93  94  95
			96  97  98  99 100 101 102 103
			104 105 106 107 108 109 110 111
			112 113 114 115 116 117 118 119
			120 121 122 123 124 125 126 127
			128 129 130 131 132 133 134 135
			136 137 138 139 140 141 142 143
			144 145 146 147 148 149 150 151
			152 153 154 155 156 157 158 159
			160 161 162 163 164 165 166 167
			168 169 170 171 172 173 174 175
			176 177 178 179 180 181 182 183
			184 185 186 187 188 189 190 191
			192 193 194 195 196 197 198 199
			200 201 202 203 204 205 206 207
			208 209 210 211 212 213 214 215
			216 217 218 219 220 221 222 223
			224 225 226 227 228 229 230 231
			232 233 234 235 236 237 238 239
			240 241 242 243 244 245 246 247
			248 249 250 251 252 253 254 255
		>;
		default-brightness-level = <200>;
	};

	tftbacklight: backlight@1 {
		status = "okay";
		compatible = "pwm-backlight";
		label = "backlight1";
		pwms = <&pwm8 0 50000 0>;
		brightness-levels = <
			95  95  95  95  95  95  95  95
			95  95  95  95  95  95  95  95
			95  95  95  95  95  95  95  95
			95  95  95  95  95  95  95  95
			95  95  95  95  95  95  95  95
			95  95  95  95  95  95  95  95
			95  95  95  95  95  95  95  95
			95  95  95  95  95  95  95  95
			95  95  95  95  95  95  95  95
			95  95  95  95  95  95  95  95
			95  95  95  95  95  95  95  95
			88  89  90  91  92  93  94  95
			96  97  98  99 100 101 102 103
			104 105 106 107 108 109 110 111
			112 113 114 115 116 117 118 119
			120 121 122 123 124 125 126 127
			128 129 130 131 132 133 134 135
			136 137 138 139 140 141 142 143
			144 145 146 147 148 149 150 151
			152 153 154 155 156 157 158 159
			160 161 162 163 164 165 166 167
			168 169 170 171 172 173 174 175
			176 177 178 179 180 181 182 183
			184 185 186 187 188 189 190 191
			192 193 194 195 196 197 198 199
			200 201 202 203 204 205 206 207
			208 209 210 211 212 213 214 215
			216 217 218 219 220 221 222 223
			224 225 226 227 228 229 230 231
			232 233 234 235 236 237 238 239
			240 241 242 243 244 245 246 247
			248 249 250 251 252 253 254 255
		>;
		default-brightness-level = <100>;
	};

	srf04@0 {
		compatible = "devantech,srf04";
		pinctrl-names = "default";
		pinctrl-0 = <&srf04_pin_1>;
		trig-gpios = <&gpio1 RK_PB0 GPIO_ACTIVE_HIGH>; // GPIO1_B0
		echo-gpios = <&gpio1 RK_PA7 GPIO_ACTIVE_HIGH>; // GPIO1_A7
        status = "okay";
	};

	rotary: rotary-encoder {
		compatible = "rotary-encoder";
		pinctrl-names = "default";
		pinctrl-0 = <&rotary_pin>;
		gpios = <&gpio1 RK_PA2 GPIO_ACTIVE_HIGH>, <&gpio1 RK_PA3 GPIO_ACTIVE_HIGH>; //GPIO1_PA2 GPIO1_PA3
		linux,axis = <0>; /* REL_X */
		rotary-encoder,encoding = "gray";
		rotary-encoder,relative-axis;
		status = "okay";
	};

	wifi_usb: wifi-usb {
		compatible = "regulator-fixed";
		regulator-name = "wifi_usb";
		regulator-min-microvolt = <3300000>;
		regulator-max-microvolt = <3300000>;
		pinctrl-names = "default";
		pinctrl-0 = <&wifi_poweren_gpio>;		
		regulator-always-on;
		enable-active-low;
		gpio = <&gpio0 RK_PC1 GPIO_ACTIVE_LOW>;
	};

	test-power {
		status = "okay";
	};
};

&saradc {
	vref-supply = <&vcca_1v8>;
	status = "okay";
};

&tsadc {
	status = "okay";
};

&pwm0 {
	status = "okay";
	pinctrl-0 = <&pwm0m1_pins>;
};

&cpu0 {
	cpu-supply = <&vdd_cpu>;
};

&dfi {
	status = "okay";
};

&dmc {
	center-supply = <&vdd_logic>;
	status = "okay";
};

&gpu {
	mali-supply = <&vdd_gpu>;
	status = "okay";
};

&i2c0 {
	status = "okay";

	vdd_cpu: tcs4525@1c {
		compatible = "tcs,tcs452x";
		reg = <0x1c>;
		vin-supply = <&vcc5v0_sys>;
		regulator-compatible = "fan53555-reg";
		regulator-name = "vdd_cpu";
		regulator-min-microvolt = <712500>;
		regulator-max-microvolt = <1390000>;
		regulator-ramp-delay = <2300>;
		fcs,suspend-voltage-selector = <1>;
		regulator-boot-on;
		regulator-always-on;
		regulator-state-mem {
			regulator-off-in-suspend;
		};
	};

	rk809: pmic@20 {
		compatible = "rockchip,rk809";
		reg = <0x20>;
		interrupt-parent = <&gpio0>;
		interrupts = <3 IRQ_TYPE_LEVEL_LOW>;

		pinctrl-names = "default", "pmic-sleep",
						"pmic-power-off", "pmic-reset";
		pinctrl-0 = <&pmic_int>;
		pinctrl-1 = <&soc_slppin_slp>, <&rk817_slppin_slp>;
		pinctrl-2 = <&soc_slppin_gpio>, <&rk817_slppin_pwrdn>;
		pinctrl-3 = <&soc_slppin_gpio>, <&rk817_slppin_rst>;

		rockchip,system-power-controller;
		wakeup-source;
		#clock-cells = <1>;
		clock-output-names = "rk808-clkout1", "rk808-clkout2";
		//fb-inner-reg-idxs = <2>;
		/* 1: rst regs (default in codes), 0: rst the pmic */
		pmic-reset-func = <0>;
		/* not save the PMIC_POWER_EN register in uboot */
		not-save-power-en = <1>;

		vcc1-supply = <&vcc3v3_sys>;
		vcc2-supply = <&vcc3v3_sys>;
		vcc3-supply = <&vcc3v3_sys>;
		vcc4-supply = <&vcc3v3_sys>;
		vcc5-supply = <&vcc3v3_sys>;
		vcc6-supply = <&vcc3v3_sys>;
		vcc7-supply = <&vcc3v3_sys>;
		vcc8-supply = <&vcc3v3_sys>;
		vcc9-supply = <&vcc3v3_sys>;

		pwrkey {
			status = "okay";
		};

		pinctrl_rk8xx: pinctrl_rk8xx {
			gpio-controller;
			#gpio-cells = <2>;

			rk817_slppin_null: rk817_slppin_null {
				pins = "gpio_slp";
				function = "pin_fun0";
			};

			rk817_slppin_slp: rk817_slppin_slp {
				pins = "gpio_slp";
				function = "pin_fun1";
			};

			rk817_slppin_pwrdn: rk817_slppin_pwrdn {
				pins = "gpio_slp";
				function = "pin_fun2";
			};

			rk817_slppin_rst: rk817_slppin_rst {
				pins = "gpio_slp";
				function = "pin_fun3";
			};
		};

		regulators {
			vdd_logic: DCDC_REG1 {
				regulator-always-on;
				regulator-boot-on;
				regulator-min-microvolt = <500000>;
				regulator-max-microvolt = <1350000>;
				regulator-init-microvolt = <900000>;
				regulator-ramp-delay = <6001>;
				regulator-initial-mode = <0x2>;
				regulator-name = "vdd_logic";
				regulator-state-mem {
					regulator-off-in-suspend;
				};
			};

			vdd_gpu: DCDC_REG2 {
				regulator-always-on;
				regulator-boot-on;
				regulator-min-microvolt = <500000>;
				regulator-max-microvolt = <1350000>;
				regulator-init-microvolt = <900000>;
				regulator-ramp-delay = <6001>;
				regulator-initial-mode = <0x2>;
				regulator-name = "vdd_gpu";
				regulator-state-mem {
					regulator-off-in-suspend;
				};
			};

			vcc_ddr: DCDC_REG3 {
				regulator-always-on;
				regulator-boot-on;
				regulator-initial-mode = <0x2>;
				regulator-name = "vcc_ddr";
				regulator-state-mem {
					regulator-on-in-suspend;
				};
			};

			vdd_npu: DCDC_REG4 {
				regulator-always-on;
				regulator-boot-on;
				regulator-min-microvolt = <500000>;
				regulator-max-microvolt = <1350000>;
				regulator-init-microvolt = <900000>;
				regulator-ramp-delay = <6001>;
				regulator-initial-mode = <0x2>;
				regulator-name = "vdd_npu";
				regulator-state-mem {
					regulator-off-in-suspend;
				};
			};

			vdda0v9_image: LDO_REG1 {
				regulator-boot-on;
				regulator-always-on;
				regulator-min-microvolt = <900000>;
				regulator-max-microvolt = <900000>;
				regulator-name = "vdda0v9_image";
				regulator-state-mem {
					regulator-off-in-suspend;
				};
			};

			vdda_0v9: LDO_REG2 {
				regulator-always-on;
				regulator-boot-on;
				regulator-min-microvolt = <900000>;
				regulator-max-microvolt = <900000>;
				regulator-name = "vdda_0v9";
				regulator-state-mem {
					regulator-off-in-suspend;
				};
			};

			vdda0v9_pmu: LDO_REG3 {
				regulator-always-on;
				regulator-boot-on;
				regulator-min-microvolt = <900000>;
				regulator-max-microvolt = <900000>;
				regulator-name = "vdda0v9_pmu";
				regulator-state-mem {
					regulator-on-in-suspend;
					regulator-suspend-microvolt = <900000>;
				};
			};

			vccio_acodec: LDO_REG4 {
				regulator-always-on;
				regulator-boot-on;
				regulator-min-microvolt = <3300000>;
				regulator-max-microvolt = <3300000>;
				regulator-name = "vccio_acodec";
				regulator-state-mem {
					regulator-off-in-suspend;
				};
			};

			vccio_sd: LDO_REG5 {
				regulator-always-on;
				regulator-boot-on;
				regulator-min-microvolt = <1800000>;
				regulator-max-microvolt = <3300000>;
				regulator-name = "vccio_sd";
				regulator-state-mem {
					regulator-off-in-suspend;
				};
			};

			vcc3v3_pmu: LDO_REG6 {
				regulator-always-on;
				regulator-boot-on;
				regulator-min-microvolt = <3300000>;
				regulator-max-microvolt = <3300000>;
				regulator-name = "vcc3v3_pmu";
				regulator-state-mem {
					regulator-on-in-suspend;
					regulator-suspend-microvolt = <3300000>;
				};
			};

			vcca_1v8: LDO_REG7 {
				regulator-always-on;
				regulator-boot-on;
				regulator-min-microvolt = <1800000>;
				regulator-max-microvolt = <1800000>;
				regulator-name = "vcca_1v8";
				regulator-state-mem {
					regulator-off-in-suspend;
				};
			};

			vcca1v8_pmu: LDO_REG8 {
				regulator-always-on;
				regulator-boot-on;
				regulator-min-microvolt = <1800000>;
				regulator-max-microvolt = <1800000>;
				regulator-name = "vcca1v8_pmu";
				regulator-state-mem {
					regulator-on-in-suspend;
					regulator-suspend-microvolt = <1800000>;
				};
			};

			vcca1v8_image: LDO_REG9 {
				regulator-always-on;
				regulator-boot-on;
				regulator-min-microvolt = <1800000>;
				regulator-max-microvolt = <1800000>;
				regulator-name = "vcca1v8_image";
				regulator-state-mem {
					regulator-off-in-suspend;
				};
			};

			vcc_1v8: DCDC_REG5 {
				regulator-always-on;
				regulator-boot-on;
				regulator-min-microvolt = <1800000>;
				regulator-max-microvolt = <1800000>;
				regulator-name = "vcc_1v8";
				regulator-state-mem {
					regulator-off-in-suspend;
				};
			};

			vcc_3v3: SWITCH_REG1 {
				regulator-always-on;
				regulator-boot-on;
				regulator-name = "vcc_3v3";
				regulator-state-mem {
					regulator-off-in-suspend;
				};
			};

			vcc3v3_sd: SWITCH_REG2 {
				regulator-always-on;
				regulator-boot-on;
				regulator-name = "vcc3v3_sd";
				regulator-state-mem {
					regulator-off-in-suspend;
				};
			};
		};
	};
};

&i2c1 {
	status = "okay";
	clock-frequency = <100000>;

	rockpi_ft5406: rockpi_ft5406@38 {
		compatible = "rockpi_ft5406";
		touchscreen-size-x = <480>; //屏幕分辨率
		touchscreen-size-y = <800>;
		reg = <0x38>;
		// interrupt-parent = <&gpio3>;
		// interrupts = <RK_PA1 IRQ_TYPE_LEVEL_LOW>;
		// reset-gpios = <&gpio3 RK_PA2 GPIO_ACTIVE_LOW>;
		// irq-gpios = <&gpio3 RK_PA1 GPIO_ACTIVE_HIGH>;
		status = "okay";
	};

	gt911: gt911@5d {
		status = "okay";
		compatible = "goodix,gt911";
		reg = <0x5d>;
		interrupt-parent = <&gpio3>;
		interrupts = <RK_PA1 IRQ_TYPE_LEVEL_LOW>;
		reset-gpios = <&gpio3 RK_PA2 GPIO_ACTIVE_LOW>;
		irq-gpios = <&gpio3 RK_PA1 GPIO_ACTIVE_HIGH>;
		// touchscreen-inverted-x = <1>;
		// touchscreen-inverted-y = <1>;
	};
};

//cam-gpio-setting
&ov5647 {
    pwdn-gpios = <&gpio0 RK_PC3 GPIO_ACTIVE_LOW>;
};

&ov5648 {
	pwdn-gpios = <&gpio0 RK_PC3 GPIO_ACTIVE_HIGH>;
	reset-gpios = <&gpio0 RK_PC4 GPIO_ACTIVE_LOW>;
};

&ov8858 {
	pwdn-gpios = <&gpio0 RK_PC3 GPIO_ACTIVE_HIGH>;
	reset-gpios = <&gpio0 RK_PC4 GPIO_ACTIVE_HIGH>;
};

&ov13850 {
	pwdn-gpios = <&gpio0 RK_PC3 GPIO_ACTIVE_HIGH>;
	reset-gpios = <&gpio0 RK_PC4 GPIO_ACTIVE_HIGH>;
};
 
&sc132gs {
	pwdn-gpios = <&gpio0 RK_PC3 GPIO_ACTIVE_HIGH>;
	reset-gpios = <&gpio0 RK_PC4 GPIO_ACTIVE_HIGH>;
};


&iep {
	status = "okay";
};

&iep_mmu {
	status = "okay";
};

&jpegd {
	status = "okay";
};

&jpegd_mmu {
	status = "okay";
};

&mpp_srv {
	status = "okay";
};

&pmu_io_domains {
	status = "okay";
	pmuio2-supply = <&vcc3v3_pmu>;
	vccio1-supply = <&vccio_acodec>;
	vccio3-supply = <&vccio_sd>;
	vccio4-supply = <&vcc_3v3>;
	vccio5-supply = <&vcc_3v3>;
	vccio6-supply = <&vcc_1v8>;
	vccio7-supply = <&vcc_3v3>;
};

&rk_rga {
	status = "okay";
};

&rkvdec {
	status = "okay";
};

&rkvdec_mmu {
	status = "okay";
};

&rkvenc {
	venc-supply = <&vdd_logic>;
	status = "okay";
};

&rkvenc_mmu {
	status = "okay";
};

&rknpu {
	rknpu-supply = <&vdd_npu>;
	status = "okay";
};

&rknpu_mmu {
	status = "okay";
};

&bus_npu {
	bus-supply = <&vdd_logic>;
	pvtm-supply = <&vdd_cpu>;
	status = "okay";
};

&sdhci {
	bus-width = <8>;
	supports-emmc;
	non-removable;
	max-frequency = <200000000>;
	status = "okay";
};

&sdmmc0 {
	max-frequency = <150000000>;
	supports-sd;
	bus-width = <4>;
	cap-mmc-highspeed;
	cap-sd-highspeed;
	disable-wp;
	sd-uhs-sdr104;
	vmmc-supply = <&vcc3v3_sd>;
	vqmmc-supply = <&vccio_sd>;
	pinctrl-names = "default";
	pinctrl-0 = <&sdmmc0_bus4 &sdmmc0_clk &sdmmc0_cmd &sdmmc0_det>;
	status = "okay";
};

&uart1 {
	status = "okay";
	pinctrl-names = "default";
	pinctrl-0 = <&uart1m0_xfer &uart1m0_ctsn>;
};

&vdpu {
	status = "okay";
};

&vdpu_mmu {
	status = "okay";
};

&vepu {
	status = "okay";
};

&vepu_mmu {
	status = "okay";
};

&vop {
	status = "okay";
	assigned-clocks = <&cru DCLK_VOP0>, <&cru DCLK_VOP1>;
	assigned-clock-parents = <&pmucru PLL_HPLL>, <&cru PLL_VPLL>;
};

&vop_mmu {
	status = "okay";
};

&vp0 {
	rockchip,plane-mask = <(1 << ROCKCHIP_VOP2_CLUSTER0 | 1 << ROCKCHIP_VOP2_ESMART0 | 1 << ROCKCHIP_VOP2_SMART0)>;
	rockchip,primary-plane = <ROCKCHIP_VOP2_SMART0>;
	// cursor-win-id = <ROCKCHIP_VOP2_CLUSTER0>;
};

&vp1 {
	rockchip,plane-mask = <(1 << ROCKCHIP_VOP2_CLUSTER1 | 1 << ROCKCHIP_VOP2_ESMART1 | 1 << ROCKCHIP_VOP2_SMART1)>;
	rockchip,primary-plane = <ROCKCHIP_VOP2_SMART1>;
	// cursor-win-id = <ROCKCHIP_VOP2_CLUSTER1>;
};

&rng {
	status = "okay";
};

/* USB OTG/USB Host_1 USB 2.0 Comb */
&usb2phy0 {
	status = "okay";
};

&u2phy0_host {
	status = "okay";
};

&u2phy0_otg {
	status = "okay";
};

&usb_host0_ehci {
	status = "okay";
};

&usb_host0_ohci {
	status = "okay";
};

/* USB Host_2/USB Host_3 USB 2.0 Comb */
&usb2phy1 {
	status = "okay";
};

&u2phy1_otg {
	status = "okay";
};

&u2phy1_host {
	status = "okay";
};

&usb_host1_ehci {
	status = "okay";
};

&usb_host1_ohci {
	status = "okay";
};

/* USB3.0 OTG Only USB2.0 */
&usbdrd30 {
	status = "okay";
};

&usbdrd_dwc3 {
	dr_mode = "host";
	status = "okay";
};

/* USB3.0 Host to USB2.0 only */
&combphy1_usq {
	rockchip,dis-u3otg1-port; /* 配置 dwc3_1 控制器最高支持 high speed */
	status = "okay";
};

&usbhost30 {
	status = "okay";
};

&usbhost_dwc3 {
	phys = <&u2phy0_host>; /* 配置 phys 属性只引用 usb 2.0 phy 节点 */
	phy-names = "usb2-phy";
	maximum-speed = "high-speed"; /* 配置 dwc3 控制器最高支持 high speed */
	status = "okay";
};

&gmac1 {
	phy-mode = "rgmii";
	clock_in_out = "output";

	snps,reset-gpio = <&gpio2 RK_PB0 GPIO_ACTIVE_LOW>;
	snps,reset-active-low;
	/* Reset time is 75ms, 100ms */
	snps,reset-delays-us = <0 75000 100000>;

	assigned-clocks = <&cru SCLK_GMAC1_RX_TX>, <&cru SCLK_GMAC1>;
	assigned-clock-parents = <&cru SCLK_GMAC1_RGMII_SPEED>, <&cru CLK_MAC1_2TOP>;
	assigned-clock-rates = <0>, <125000000>;

	pinctrl-names = "default";
	pinctrl-0 = <&gmac1m1_miim
			 &gmac1m1_tx_bus2_level3
			 &gmac1m1_rx_bus2
			 &gmac1m1_rgmii_clk_level2
			 &gmac1m1_rgmii_bus_level3>;

	tx_delay = <0x24>;
	rx_delay = <0x08>;

	phy-handle = <&rgmii_phy1>;
	status = "disabled";
};

&mdio1 {
	rgmii_phy1: phy@0 {
		compatible = "ethernet-phy-ieee802.3-c22";
		reg = <0x0>;
		jl2xxx,led-enable = <(JL2XXX_LED_STATIC_OP_EN | JL1XXX_LED_MODE_EN)>;
		jl2xxx,led-mode = <(JL2XXX_LED1_LINK10  | \
				 JL2XXX_LED1_LINK100  | \
				 JL2XXX_LED1_LINK1000 | \
				 JL2XXX_LED2_LINK10   | \
				 JL2XXX_LED2_LINK100  | \
				 JL2XXX_LED2_LINK1000 | \
				 JL2XXX_LED2_ACTIVITY )>;
	};
};

&combphy2_psq {
		status = "okay";
};

&pinctrl {
	pmic {
		pmic_int: pmic_int {
			rockchip,pins = <0 RK_PA3 RK_FUNC_GPIO &pcfg_pull_up>;
		};

		soc_slppin_gpio: soc_slppin_gpio {
			rockchip,pins = <0 RK_PA2 RK_FUNC_GPIO &pcfg_output_low_pull_down>;
		};

		soc_slppin_slp: soc_slppin_slp {
			rockchip,pins = <0 RK_PA2 RK_FUNC_1 &pcfg_pull_up>;
		};

		soc_slppin_rst: soc_slppin_rst {
			rockchip,pins = <0 RK_PA2 RK_FUNC_2 &pcfg_pull_none>;
		};

		spk_ctl_gpio: spk_ctl_gpio {
			rockchip,pins = <3 RK_PC5 RK_FUNC_GPIO &pcfg_pull_up>;
		};
	};

	wireless-wlan {
		wifi_poweren_gpio: wifi-poweren-gpio {
			rockchip,pins = <0 RK_PC1 RK_FUNC_GPIO &pcfg_pull_none>;
		};
	};

	lcd {
		mipi_dsi0_pwr_en: mipi-dsi0-pwr-en {
			rockchip,pins = <0 RK_PC0 RK_FUNC_GPIO &pcfg_pull_none>;
		};
	};

	cam {
		cam_pwr_en: cam-pwr-en {
			rockchip,pins = <0 RK_PC6 RK_FUNC_GPIO &pcfg_pull_none>;
		};
	};

	leds {
		sys_status_led_pin: sys-status-led-pin {
			rockchip,pins = <0 RK_PC7 RK_FUNC_GPIO &pcfg_pull_none>;
		};
	};

	lpwm {
		lpwm_pin: lpwm-pin {
			rockchip,pins = <2 RK_PC4 RK_FUNC_GPIO &pcfg_pull_none>;
		};
	};

	rpwm {
		rpwm_pin: rpwm-pin {
			rockchip,pins = <1 RK_PA5 RK_FUNC_GPIO &pcfg_pull_none>;
		};
	};

	srf04 {
		srf04_pin_1: srf041-pins {
			rockchip,pins =
			<1 RK_PA7 RK_FUNC_GPIO &pcfg_pull_none>,
			<1 RK_PB0 RK_FUNC_GPIO &pcfg_pull_none>;
		};
	};

	rotary {
		rotary_pin: rotary-pins {
			rockchip,pins =
			<1 RK_PA2 RK_FUNC_GPIO &pcfg_pull_none>,
			<1 RK_PA3 RK_FUNC_GPIO &pcfg_pull_none>;
		};
	};

	pwm3 {
		pwm3_pins: pwm3-pins {
			rockchip,pins =
				<0 RK_PC2 1 &pcfg_pull_none>;
		};
	};

	pwm8 {
		pwm8m0_pins: pwm8m0-pins {
			rockchip,pins =
				<3 RK_PB1 5 &pcfg_pull_none>;
		};
	};

	pwm9 {
		pwm9m0_pins: pwm9m0-pins {
			rockchip,pins =
				<3 RK_PB2 5 &pcfg_pull_none>;
		};
	};

	pwm11 {
		pwm11m0_pins: pwm11m0-pins {
			rockchip,pins =
				<3 RK_PB6 5 &pcfg_pull_none>;
		};
	};

	spi3 {
		spi3m1_pins: spi3m1-pins {
			rockchip,pins =
				/* spi3_clkm1 */
				<4 RK_PC2 2 &pcfg_pull_none>,
				/* spi3_misom1 */
				<4 RK_PC5 2 &pcfg_pull_none>,
				/* spi3_mosim1 */
				<4 RK_PC3 2 &pcfg_pull_none>;
		};

		spi3_pins_cs: spi3cs-pins {
			rockchip,pins =
			<4 RK_PC6 RK_FUNC_GPIO &pcfg_pull_none>,
			<1 RK_PB3 RK_FUNC_GPIO &pcfg_pull_none>;
		};
	};

	uart1 {
		uart1m0_xfer: uart1m0-xfer {
			rockchip,pins =
				/* uart1_rxm0 */
				<2 RK_PB3 2 &pcfg_pull_up>,
				/* uart1_txm0 */
				<2 RK_PB4 2 &pcfg_pull_up>;
		};

		uart1m0_ctsn: uart1m0-ctsn {
			rockchip,pins =
				/* uart1m0_ctsn */
				<2 RK_PB6 2 &pcfg_pull_none>;
		};
	};

	uart2 {
		/omit-if-no-ref/
		uart2m0_xfer: uart2m0-xfer {
			rockchip,pins =
				/* uart2_rxm0 */
				<0 RK_PD0 1 &pcfg_pull_up>,
				/* uart2_txm0 */
				<0 RK_PD1 1 &pcfg_pull_up>;
		};
	};

	uart3 {
		uart3m0_xfer: uart3m0-xfer {
			rockchip,pins =
				/* uart3_rxm0 */
				<1 RK_PA0 2 &pcfg_pull_up>,
				/* uart3_txm0 */
				<1 RK_PA1 2 &pcfg_pull_up>;
		};
	};

	uart8 {
		uart8m0_xfer: uart8m0-xfer {
			rockchip,pins =
				/* uart8_rxm0 */
				<2 RK_PC6 2 &pcfg_pull_up>,
				/* uart8_txm0 */
				<2 RK_PC5 3 &pcfg_pull_up>;
		};
	};

	i2c5 {
		i2c5m0_xfer: i2c5m0-xfer {
			rockchip,pins =
				/* i2c5_sclm0 */
				<3 RK_PB3 4 &pcfg_pull_none_smt>,
				/* i2c5_sdam0 */
				<3 RK_PB4 4 &pcfg_pull_none_smt>;
		};
	};

	t_irq {
		t_irq: t_irq {
			rockchip,pins =
				<3 RK_PA7 RK_FUNC_GPIO &pcfg_pull_none>;
		};
	};

	can_pin_irq {
		can0_int: can0-int {
			rockchip,pins =
				<3 RK_PA7 RK_FUNC_GPIO &pcfg_pull_none>;
		};
	};

	rfid {
		rfid_int: rfid-int {
			rockchip,pins =
				<1 RK_PB1 RK_FUNC_GPIO &pcfg_pull_none>;
		};
	};
};

&pwm3 {
	pinctrl-0 = <&pwm3_pins>;
	status = "okay";
};

&pwm8 {
	pinctrl-0 = <&pwm8m0_pins>;
	status = "okay";
};

&pwm9 {
	pinctrl-0 = <&pwm9m0_pins>;
	status = "okay";
};

&pwm11 {
	pinctrl-0 = <&pwm11m0_pins>;
	status = "okay";
};

&spi3 {
	pinctrl-names = "default";
	pinctrl-0 = <&spi3m1_pins &spi3_pins_cs>;
	spi-num-chipselects = <3>;
	cs-gpios = <&gpio4 RK_PC6 GPIO_ACTIVE_HIGH>, <&gpio1 RK_PB3 GPIO_ACTIVE_HIGH>, <&gpio2 RK_PC3 GPIO_ACTIVE_HIGH>;
	status = "okay";

	ili9341@0 {
		compatible = "ilitek,ili9341";
		reg = <0>;
		status = "okay";
		spi-max-frequency = <50000000>;
		rotate = <90>;
		bgr;
		fps = <30>;
		buswidth = <8>;
		dc-gpios = <&gpio3 RK_PA6 GPIO_ACTIVE_HIGH>;	//GPIO3_A6
		debug = <0>;
		backlight = <&tftbacklight>;
	};

	tsc2046@1 {
		reg = <1>;	// CS1
		status = "okay";
		compatible = "ti,tsc2046";
		pinctrl-names = "default";
		pinctrl-0 = <&t_irq>;
		interrupt-parent = <&gpio3>;
		interrupts = <RK_PA7 IRQ_TYPE_LEVEL_LOW>; // GPIO3_A7
		spi-max-frequency = <1000000>;
		pendown-gpio = <&gpio3 RK_PA7 GPIO_ACTIVE_LOW>; // GPIO3_A7
		vcc-supply = <&vcc3v3_sys>;

		ti,x-min = /bits/ 16 <0>;
		ti,x-max = /bits/ 16 <320>;
		ti,y-min = /bits/ 16 <0>;
		ti,y-max = /bits/ 16 <240>;
		ti,x-plate-ohms = /bits/ 16 <40>;
		ti,pressure-max = /bits/ 16 <255>;

		wakeup-source;
	};

	rfid_rc522@3{
        compatible = "rfid,rfid_rc522";
        reg = <2>;  /* CS #0 */
        spi-max-frequency = <8000000>;
		pinctrl-names = "default";
		pinctrl-0 = <&rfid_int>;
		interrupt-parent = <&gpio1>;
		interrupts = <RK_PB1 IRQ_TYPE_LEVEL_LOW>; // GPIO1_B1
    };
};

&uart3 {
	pinctrl-names = "default";
	pinctrl-0 = <&uart3m0_xfer>;
	status = "okay";
};

&uart4 {
	pinctrl-names = "default";
	pinctrl-0 = <&uart4m0_xfer>;
	status = "okay";
};

&uart8 {
	pinctrl-names = "default";
	pinctrl-0 = <&uart8m0_xfer>;
	status = "okay";
};

&i2c5 {
	pinctrl-names = "default";
	pinctrl-0 = <&i2c5m0_xfer>;
	status = "okay";
#if 0
	mpu6050@68 {
		compatible = "invensense,mpu6050";
		reg = <0x68>;
		status = "disabled";
		interrupt-parent = <&gpio1>;
		interrupts = <RK_PA4 IRQ_TYPE_EDGE_RISING>; // GPIO1_A4
		orientation = <0xff 0 0 0 1 0 0 0 0xff>;
	};
#endif
    vl53l0x@29 {
		compatible = "st,vl53l0x";
		reg = <0x29>;
		interrupt-parent = <&gpio3>;
		interrupts = <RK_PA5 IRQ_TYPE_EDGE_FALLING>; //GPIO3_A5
		status = "okay";
	};
};

&route_dsi0 {
	status = "okay";
	connect = <&vp0_out_dsi0>;
};

&video_phy0 {
	status = "okay";
};

&dsi0_in_vp0 {
	status = "okay";
};

&dsi0_in_vp1 {
	status = "disabled";
};

&dsi0 {
	status = "okay";
	power-supply = <&mipi_dsi0_power>;

	dsi0_panel: panel@0 {
		// compatible = "rockpi,tc358762";
		// compatible = "techstar,ts8550b", "sitronix,st7701";
		compatible = "aoly,sl008pa21y1285-b00", "simple-panel-dsi";
		reg = <0x0>;
		status = "okay";

		// VCC-supply = <&mipi_dsi0_power>;
        IOVCC-supply = <&vcc3v3_sys>;

		reset-gpios = <&gpio3 RK_PA4 GPIO_ACTIVE_LOW>; // LCD-RST
		backlight = <&backlight>;

		prepare-delay-ms = <120>;
		reset-delay-ms = <120>;
		init-delay-ms = <120>;
		enable-delay-ms = <120>;
		disable-delay-ms = <120>;
		unprepare-delay-ms = <120>;

		size,width = <217>;
		size,height = <136>;

		dsi,flags = <(MIPI_DSI_MODE_VIDEO | MIPI_DSI_MODE_VIDEO_BURST | MIPI_DSI_MODE_LPM | MIPI_DSI_MODE_EOT_PACKET)>;
		dsi,format = <MIPI_DSI_FMT_RGB888>;
		dsi,lanes  = <2>;

		panel-init-sequence = [
			05 78 01 11
			39 00 06 FF 77 01 00 00 10
            39 00 03 C0 63 00
            39 00 03 C1 11 02
            39 00 03 C2 31 08
			15 00 02 CC 10
			15 00 02 CD 08
            39 00 11 B0 40 01 46 0D 13 09 05 09 09 1B 07 15 12 4C 10 C8
            39 00 11 B1 40 02 86 0D 13 09 05 09 09 1F 07 15 12 15 19 08
            39 00 06 FF 77 01 00 00 11
			15 00 02 B0 50
			15 00 02 B1 75
			15 00 02 B2 07
			15 00 02 B3 80
			15 00 02 B5 47
			15 00 02 B7 85
			15 00 02 B8 21
			15 00 02 B9 10
			15 00 02 C1 78
			15 00 02 C2 78
			15 64 02 D0 88
            39 00 04 E0 00 00 02
            39 00 0C E1 08 00 0A 00 07 00 09 00 00 33 33
            39 00 0E E2 00 00 00 00 00 00 00 00 00 00 00 00 00
            39 00 05 E3 00 00 33 33
            39 00 03 E4 44 44
            39 00 11 E5 0E 2D A0 A0 10 2D A0 A0 0A 2D A0 A0 0C 2D A0 A0
            39 00 05 E6 00 00 33 33
            39 00 03 E7 44 44
            39 00 11 E8 0D 2D A0 A0 0F 2D A0 A0 09 2D A0 A0 0B 2D A0 A0
            39 00 08 EB 02 01 E4 E4 44 00 40
            39 00 03 EC 02 01
            39 00 11 ED AB 89 76 54 01 FF FF FF FF FF FF 10 45 67 98 BA
            39 00 06 FF 77 01 00 00 00
			15 00 02 3A 77
			15 00 02 36 00
			05 14 01 29
		];

		panel-exit-sequence = [
			05 00 01 28
			05 00 01 10
		];

		disp_timings0: display-timings {
			native-mode = <&dsi0_timing0>;
			dsi0_timing0: timing0 {
				clock-frequency = <27000000>;
				hactive = <480>;
				vactive = <800>;
				hfront-porch = <150>;
				hsync-len = <10>;
				hback-porch = <10>;
				vfront-porch = <14>;
				vsync-len = <4>;
				vback-porch = <6>;
				hsync-active = <1>;
				vsync-active = <1>;
				de-active = <0>;
				pixelclk-active = <1>;
			};
		};

		ports {
			#address-cells = <1>;
			#size-cells = <0>;

			port@0 {
				reg = <0>;
				panel_in_dsi: endpoint {
					remote-endpoint = <&dsi_out_panel>;
				};
			};
		};
	};

	ports {
		#address-cells = <1>;
		#size-cells = <0>;

		port@1 {
			reg = <1>;
			dsi_out_panel: endpoint {
				remote-endpoint = <&panel_in_dsi>;
			};
		};
	};
};
