MagicPrince666/smart_car_chassis/src/chassis/src/sensor/imu_modules/mpu6050.cpp

#include <assert.h>
#include <cmath>
#include <fstream>
#include <iostream>
#include <map>
#include <sstream>
#include <sys/stat.h>

#include "interface.h"
#include "mpu6050.h"
#include "utils.h"
#include "gpio_chip.h"
#include "driver_mpu6050_interface.h"

static void a_receive_callback(uint8_t type)
{
    switch (type) {
    case MPU6050_INTERRUPT_MOTION: {
        mpu6050_interface_debug_print("mpu6050: irq motion.\n");

        break;
    }
    case MPU6050_INTERRUPT_FIFO_OVERFLOW: {
        mpu6050_interface_debug_print("mpu6050: irq fifo overflow.\n");

        break;
    }
    case MPU6050_INTERRUPT_I2C_MAST: {
        mpu6050_interface_debug_print("mpu6050: irq i2c master.\n");

        break;
    }
    case MPU6050_INTERRUPT_DMP: {
        mpu6050_interface_debug_print("mpu6050: irq dmp\n");

        break;
    }
    case MPU6050_INTERRUPT_DATA_READY: {
        mpu6050_interface_debug_print("mpu6050: irq data ready\n");

        break;
    }
    default: {
        mpu6050_interface_debug_print("mpu6050: irq unknown code.\n");

        break;
    }
    }
}

static void a_dmp_tap_callback(uint8_t count, uint8_t direction)
{
    switch (direction) {
    case MPU6050_DMP_TAP_X_UP: {
        mpu6050_interface_debug_print("mpu6050: tap irq x up with %d.\n", count);

        break;
    }
    case MPU6050_DMP_TAP_X_DOWN: {
        mpu6050_interface_debug_print("mpu6050: tap irq x down with %d.\n", count);

        break;
    }
    case MPU6050_DMP_TAP_Y_UP: {
        mpu6050_interface_debug_print("mpu6050: tap irq y up with %d.\n", count);

        break;
    }
    case MPU6050_DMP_TAP_Y_DOWN: {
        mpu6050_interface_debug_print("mpu6050: tap irq y down with %d.\n", count);

        break;
    }
    case MPU6050_DMP_TAP_Z_UP: {
        mpu6050_interface_debug_print("mpu6050: tap irq z up with %d.\n", count);

        break;
    }
    case MPU6050_DMP_TAP_Z_DOWN: {
        mpu6050_interface_debug_print("mpu6050: tap irq z down with %d.\n", count);

        break;
    }
    default: {
        mpu6050_interface_debug_print("mpu6050: tap irq unknown code.\n");

        break;
    }
    }
}

static void a_dmp_orient_callback(uint8_t orientation)
{
    switch (orientation) {
    case MPU6050_DMP_ORIENT_PORTRAIT: {
        mpu6050_interface_debug_print("mpu6050: orient irq portrait.\n");

        break;
    }
    case MPU6050_DMP_ORIENT_LANDSCAPE: {
        mpu6050_interface_debug_print("mpu6050: orient irq landscape.\n");

        break;
    }
    case MPU6050_DMP_ORIENT_REVERSE_PORTRAIT: {
        mpu6050_interface_debug_print("mpu6050: orient irq reverse portrait.\n");

        break;
    }
    case MPU6050_DMP_ORIENT_REVERSE_LANDSCAPE: {
        mpu6050_interface_debug_print("mpu6050: orient irq reverse landscape.\n");

        break;
    }
    default: {
        mpu6050_interface_debug_print("mpu6050: orient irq unknown code.\n");

        break;
    }
    }
}

Mpu6050::Mpu6050(ImuConf conf) : ImuInterface(conf), module_name_("mpu6050")
{
    mpu_int_ = nullptr;
    GpioInterruptInit();
    // assert(mpu_int_ != nullptr);
    std::cout << BOLDGREEN << "Mpu6050 Iio bus path " << imu_conf_.port << std::endl;
    mpu6050_interface_set(imu_conf_.port.c_str());
}

Mpu6050::~Mpu6050()
{
    if (imu_thread_.joinable()) {
        imu_thread_.join();
    }
    GpioInterruptDeinit();
    /* deinit */
    (void)mpu6050_dmp_deinit();
    std::cout << BOLDGREEN << "Close mpu6050 device!" << std::endl;
}

bool Mpu6050::Init()
{
    imu_thread_ = std::thread([](Mpu6050 *p_this) { p_this->Mpu6050Loop(); }, this);
    return true;
}

void Mpu6050::Euler2Quaternion(float roll, float pitch, float yaw, Quaternion &quat)
{
    double cr = cos(roll * 0.5);
    double sr = sin(roll * 0.5);
    double cy = cos(yaw * 0.5);
    double sy = sin(yaw * 0.5);
    double cp = cos(pitch * 0.5);
    double sp = sin(pitch * 0.5);
    quat.w    = cy * cp * cr + sy * sp * sr;
    quat.x    = cy * cp * sr - sy * sp * cr;
    quat.y    = sy * cp * sr + cy * sp * cr;
    quat.z    = sy * cp * cr - cy * sp * sr;
}

int Mpu6050::GpioInterruptInit()
{
    if (!imu_conf_.int_chip.empty() && imu_conf_.int_line != -1) {
        mpu_int_ = std::make_shared<GpioChip>(imu_conf_.int_chip, imu_conf_.int_line);
        mpu_int_->AddEvent(std::bind(&Mpu6050::ReadHander, this, std::placeholders::_1, std::placeholders::_2));
        mpu_int_->Init();
    }
    return 0;
}

void Mpu6050::GpioInterruptDeinit()
{
    // delete mpu_int_;
}

void Mpu6050::ReadHander(const bool val, const uint64_t timestamp)
{
    if (!val) {
        mpu6050_dmp_irq_handler();
    }
    if (timestamp) {}
}

void Mpu6050::Mpu6050Loop()
{
    /* run dmp function */
    if (mpu6050_dmp_init(MPU6050_ADDRESS_AD0_LOW, a_receive_callback,
                         a_dmp_tap_callback, a_dmp_orient_callback) != 0) {
        GpioInterruptDeinit();
        RCLCPP_ERROR(rclcpp::get_logger(__FUNCTION__), "dmp init fail!!");
        return;
    }

    /* delay 500 ms */
    mpu6050_interface_delay_ms(500);

    uint16_t fifo_len = 128;
    uint32_t cnt;
    int16_t gs_accel_raw[128][3];
    int16_t gs_gyro_raw[128][3];
    float gs_accel_g[128][3];
    float gs_gyro_dps[128][3];
    int32_t gs_quat[128][4];
    float gs_pitch[128];
    float gs_roll[128];
    float gs_yaw[128];

#if defined(USE_ROS_NORTIC_VERSION) || defined(USE_ROS_MELODIC_VERSION)
    while (ros::ok())
#else
    while (rclcpp::ok())
#endif
    {
        /* read */
        if (mpu6050_dmp_read_all(gs_accel_raw, gs_accel_g,
                                 gs_gyro_raw, gs_gyro_dps,
                                 gs_quat,
                                 gs_pitch, gs_roll, gs_yaw,
                                 &fifo_len) != 0) {
            (void)mpu6050_dmp_deinit();
            GpioInterruptDeinit();
            RCLCPP_ERROR(rclcpp::get_logger(__FUNCTION__), "dmp read all fail!!");
            return;
        }

        /* output */
        // RCLCPP_INFO(rclcpp::get_logger(__FUNCTION__), "fifo %d.", fifo_len);
        // RCLCPP_INFO(rclcpp::get_logger(__FUNCTION__), "pitch: %f\troll: %f\tyaw: %f", gs_pitch[0], gs_roll[0], gs_yaw[0]);

        // RCLCPP_INFO(rclcpp::get_logger(__FUNCTION__), "acc x[0] is %fg.", gs_accel_g[0][0]);
        // RCLCPP_INFO(rclcpp::get_logger(__FUNCTION__), "acc y[0] is %fg.", gs_accel_g[0][1]);
        // RCLCPP_INFO(rclcpp::get_logger(__FUNCTION__), "acc z[0] is %fg.", gs_accel_g[0][2]);

        // RCLCPP_INFO(rclcpp::get_logger(__FUNCTION__), "gyro x[0] is %fdps.", gs_gyro_dps[0][0]);
        // RCLCPP_INFO(rclcpp::get_logger(__FUNCTION__), "gyro y[0] is %fdps.", gs_gyro_dps[0][1]);
        // RCLCPP_INFO(rclcpp::get_logger(__FUNCTION__), "gyro z[0] is %fdps.", gs_gyro_dps[0][2]);

        data_lock_.lock();
        imu_data_.eular.pitch = gs_pitch[0] * M_PI / 180.0;
        imu_data_.eular.roll  = gs_roll[0] * M_PI / 180.0;
        imu_data_.eular.yaw   = gs_yaw[0] * M_PI / 180.0;
        imu_data_.orientation.w         = gs_quat[0][0];
        imu_data_.orientation.x         = gs_quat[0][1];
        imu_data_.orientation.y         = gs_quat[0][2];
        imu_data_.orientation.z         = gs_quat[0][3];
        imu_data_.linear_acceleration.x = gs_accel_g[0][0];
        imu_data_.linear_acceleration.y = gs_accel_g[0][1];
        imu_data_.linear_acceleration.z = gs_accel_g[0][2];
        imu_data_.angular_velocity.x    = gs_gyro_dps[0][0] * M_PI / 180.0;
        imu_data_.angular_velocity.y    = gs_gyro_dps[0][1] * M_PI / 180.0;
        imu_data_.angular_velocity.z    = gs_gyro_dps[0][2] * M_PI / 180.0;
        data_lock_.unlock();

        mpu6050_interface_delay_ms(500);

        /* get the pedometer step count */
        if (mpu6050_dmp_get_pedometer_counter(&cnt) != 0) {
            (void)mpu6050_dmp_deinit();
            GpioInterruptDeinit();
            RCLCPP_ERROR(rclcpp::get_logger(__FUNCTION__), "dmp get pedometer counter fail!!");
            return;
        }
    }
}
