MagicPrince666/smart_car_chassis/src/chassis/src/sensor/gpio_key.h

/**
 * @file gpio_key.h
 * @author 黄李全 (846863428@qq.com)
 * @brief 按键
 * @version 0.1
 * @date 2023-04-05
 * @copyright 个人版权所有 Copyright (c) 2023
 */
#ifndef __GPIO_KEY_H__
#define __GPIO_KEY_H__

#include <sys/time.h>

class GpioKey
{
public:
    GpioKey();
    ~GpioKey();

    bool init();
    int IRKey();

private:
    int key_input_fd_{-1};
    struct timeval last_time_;
};

#endif
