MagicPrince666/smart_car_chassis/(commit log)

2024-03-04 更新原理图
    [linux-car.kicad_pcb, linux-car.kicad_sch]
2024-03-04 更新链接
2024-03-17 更新打印
2024-03-17 更新配置文件
2024-03-17 更新配置
2024-05-23 更新版本判断
2024-06-17 更新启动文件
2024-06-17 适配成功
2024-06-17 更新信息
    [raspberry.kicad_pcb, raspberry.kicad_sch, rk3566.kicad_pcb, rk3566.kicad_sch]
2024-06-18 更新机型
2024-06-19 修复接口
2024-06-19 添加底盘说明
2024-06-21 修正文档错误
2024-06-21 更新文件名
2024-06-26 更新雷达转速
2024-07-09 添加乐动雷达
2024-07-10 更新距离传感器
2024-07-10 更新tof
2024-07-14 添加脚本
2024-07-14 更新名称
2024-07-19 修复编码器
2024-07-19 添加泰山派启动
2024-07-21 默认泰山派
2024-08-15 添加遥控
2024-08-16 添加udp控制支持
2024-08-17 更新失控标识
2024-08-18 更新遥控参数
2024-08-19 更新IMU
2024-08-28 修复警告
2025-02-16 更新脚本
2025-02-16 更新包编译说明
2025-02-16 更新PWM
2025-07-06 修复遥控
2026-04-26 更新遥控
2026-04-27 更新变量范围
2026-04-29 更新支持
2026-04-30 更新版本
2026-05-05 更新泰山派配置
2026-05-05 更新sbuc遥控
2026-05-05 修复变量
2026-05-05 修改背光
